SUAT-lhy/MEISHA-V100-A-Silicon-Proven-Quad-Core-RISC-V-SoC/trunk/hw/ip/sdspi/doc/sdio.pdf

# Gisselquist Technology, LLC

# SDIO/EMMC CONTROLLER SPECIFICATION

Dan Gisselquist, Ph.D.

## dgisselq (at) ieee.org

## August 19, 2023

Gisselquist Technology, LLC | Specification | 2023/08/19

Copyright (C) 2023, Gisselquist Technology, LLC
This project is free software (firmware): you can redistribute it and/or modify it under the terms of the GNU General Public License as published by the Free Software Foundation, either version 3 of the License, or (at your option) any later version.
This program is distributed in the hope that it will be useful, but WITHOUT ANY WAR-RANTY; without even the implied warranty of MERCHANTIBILITY or FITNESS FOR A PAR-TICULAR PURPOSE. See the GNU General Public License for more details.
You should have received a copy of the GNU General Public License along with this program. If not, see http://www.gnu.org/licenses/ for a copy.
www.opencores.com | Rev. 1.0 | ii

# Revision History

Rev. | Date | Author | Description
1.0 | 8/15/2023 | Gisselquist | First release
www.opencores.com | Rev. 1.0 | iii

# Contents

Page

www.opencores.com | Rev. 1.0 | iv

# Figures

Figure | | Page
3.1. | SDIO/eMMC Controller RTL Architecture | | 6
3.2. | SDIO/eMMC CMD pin data flow | | 6
3.3. | SDIO/eMMC transmit data flow, to the device | | 7
3.4. | SDIO Verification IP | | 8
3.5. | All Verilog top-level model | | 9
3.6. | All Verilog top-level model | | 10
3.7. | Software Stack | | 10
5.1. | CMD Register fields | | 19
5.2. | PHY Front end configuration register | | 23
www.opencores.com | Rev. 1.0 | v

# Tables

Table | | Page
5.1. | I/O Peripheral Registers | | 19
5.2. | CMD Register field descriptions | | 20
5.3. | CMD response types | | 21
5.4. | CMD response types | | 21
5.5. | Potential receive error codes | | 22
5.6. | PHY Front end configuration register fields | | 24
5.7. | Clock division settings | | 25
7.1. | Wishbone Slave Datasheet | | 27
9.1. | List of IO ports | | 29
www.opencores.com | Rev. 1.0 | vi

# Preface

After using the SDSPI companion controller for many years, I came across the need for an eMMC controller. Specifically, I needed a controller that could verify that two hardware interfaces were working. The first was a full SDIO interface, the second an eMMC interface,
Since the companion SDSPI IP already existed and was sufficiently low logic, this IP took on a different set of goals. First and foremost, it was to support the full SDIO interface–all of it. Every timing mode was to be supported, as were all commands. This includes the multiple block read and write commands, not supported by the SDSPI driver. This was also built to support eMMC devices– to include both the data strobe and the eMMC device interrupt. Unlike the SDSPI controller, low logic was no longer one of my goals.

Dan Gisselquist, Ph.D.

www.opencores.com | Rev. 1.0 | vii

1.

# Introduction

This SDIO/eMMC IP core is a redesign of the SDSPI IP, specifically focusing on full feature support. Low-logic, a key goal of the SDSPI companion IP, is no longer a goal. Key measures instead include full feature support and high device throughput. A full list of the features of this IP may be found in Chapt. 2.
For those interested in the basic architecture of how this controller is put together, Chapt. 3 describes its basic components and provides illustrations of how those components work together to accomplish the various actions required of the IP. Chapt. 3 will also discuss the components of the verification architecture.
I am aware that there is an official SDIO controller register set standard. This IP does not support it, but rather uses its own register set configuration. One reason for this is simplicity. The official register set standard appeared, upon inspection, more complicated than necessary. Second, since the SDSPI register set worked so well, there didn’t seem to be a need to generate something new.
As a result, most of the registers from the SDSPI controller have been replicated here. Like the SDSPI controller, this IP has CMD, DATA/ARG, and two FIFO registers. Unlike the SDSPI controller, a fifth register has been added for PHY configuration. This directly exposes what once was the internal configuration register of the SDSPI controller. Finally, even though this IP doesn’t yet support an internal DMA, three additional registers have been reserved for a DMA address and length for later DMA integration. Chapt 4 discusses how these registers can be used to accomplish the basic operations of the card, while Chapt. 5 goes through the definition of each register in detail. Finally, this is an Open Source project. The project is was initially developed using a combination of external funding and internal research and development dollars. My intention is twofold. First, I intend to use this project to both teach others, as well as for blogging material. From this standpoint, the project exists as part of a portfolio of projects available for others to examine and judge my skills and abilities by. My second goal is to use this as a background when providing services to my customers. My typical contract is for an hourly rate only, and comes with full access to any IP I have developed. As such, additional work on this IP may be done on a pay-per hour basis. Where this project supports another project of mine, I will bill that project for any required maintenance. Likewise, if you find this IP almost meets your needs, then feel free to contract with me for any maintenance adjustments or upgrades you might need.
www.opencores.com | Rev. 1.0 | 1

2.

# Features

This IP has been designed from the ground up for full SDIO/eMMC feature support. This means that support has been built in for the following specific requirements:

- Full IO support
– | Support for both open-drain and push-pull IOs are available.
– | Both SDR and DDR modes are supported, for clocks up to 2x the system clock.
– | IP supports either 1, 4, or 8 bit bus widths
– | The eMMC data strobe is supported
- Supports both multiblock read and multiblock write commands.
These are commands that were not supported by the SDSPI IP. They are supported here, at the cost of additional logic, since the goals of this project include both full feature support and high device throughput. Therefore, these features are supported at the cost of more logic.
- Ping-pong FIFO support, so one FIFO may be active on the bus while the other is active in a transaction.
- Internal CRC generation and checking, for both command and data interfaces
- Both RX and Command timeout support. Timeouts may be adjusted at build time.
- Card detection support
- Integer clock division support starts at 2x the system clock rate, and can divide the clock all the way down to 1/1,000th of the system clock rate. Thus, for a 100 MHz system clock, clock frequencies supported include 200 MHz, 100 MHz, 50 MHz, 25 MHz, 12.5 MHz, 10 MHz, 8.3 MHz, etc., all the way down to 100 kHz.
- The SDIO clock may be stopped upon request, once all operations have come to a stop.
- Special support for eMMC’s GO IRQ STATE command. Receive timeout detection is suspended for this command. Further, it is possible to self-send a reply to this command to exit interrupt mode if the device doesn’t generate an interrupt fast enough.
- Includes software driver support for use with FATFS
- Both Verilator C++ and all Verilog device verification models are provided
www.opencores.com | Rev. 1.0 | 2

- While the IP is built for big-endian buses, optional little endian support exists
- All of the various IP modules, save for the front end itself, can be formally verified.
- 32-bit Wishbone interface.

An AXI–Lite interface may be purchased upon request. If you have no interest in purchasing such support, feel free to use the AXI to Wishbone bus bridge (https://github.com/ZipCPU/wb2axip/blob/master/rtl/axim2wbsp.v) found in my wb2axip repository. (https://github.com/ZipCPU/wb2axip)

Many, although not all, of these features have been tested as part of the 10Gb Ethernet switch KlusterLab project. It is in this project that the software has been tested and proven, and where its utility has been demonstrated.

## 2.1 Limitations

As of this current release, the IP is not as fully featured as I might like. Several details and features are missing and may (or may not) be developed in the near future as time, funding, and necessity require. The following list, therefore, outlines some of the key limitations of the controller as it exists today. It also provides a roadmap for future development.

- IO features not yet tested in hardware include: OSERDES support, DDR support, and data strobe support. To date, these features have only been tested either formally or in simulation or both.
This is due to both the voltage requirements of these extra features, as well as current circuit board design I am testing against. High speed support requires 1.8V not 3.3V, and (worse) requires a voltage switch from 3.3V to 1.8V. Second, the voltage translator we are using limits speeds to 60MHz in order to maintain the ability to support open–drain IO. Similarly, wiring the clock pin to Xilinx’s CCLK pin has limited the clock in the devices under test to a maximum of 50 MHz. Finally, success with the data strobe pin really requires that the data strobe be wired to a clock capable pin. I expect these hardware testing limitations will be addressed in the future with a better PCB design, but for the time being this statement outlines hardware testing success to date.
Please check the hwteststat.png file in the doc/ directory for the current status, and any updates on this issue.
- The verification model only supports SDIO devices at present. No model yet exists for eMMC devices.
Most of the smarts in the verification IP exists in the model’s FSM, whereas the challenging components of the interface are encapsulated in supporting modules. As a result, fixing the FSM should be a fairly easy task.
Given that the two interfaces are so similar, this hasn’t (yet) been a drawback.
- The verification model depends upon an internal memory buffer which can become quite large. Further, it doesn’t integrate nicely with the FatFS system.
Plans exist to replace the memory buffer in the SDIO VIP with a file backing. This should make it possible to model full sized SD cards.
www.opencores.com | Rev. 1.0 | 3

- The included verification test suite doesn’t (yet) support testing the software driver.
A plan exists for integrating the ZipCPU into the verification environment for the purpose of verifying the software driver in simulation.
- DMA support (currently) requires an external DMA, and transfers are limited to 32-bits per clock.
Initial plans are in place for integrated DMA support. Such an integrated controller would use the full bus width for all transfers. Unfortunately, I have no requirement for such support at this time.
- There’s no eMMC boot support at present.
This also means there’s no support for either CRC acknowledgement or negative acknowledgement tokens.
Boot support may be added in the future. As with the DMA feature, I have no requirement for this capability at present.
- The model doesn’t (yet) support all SDIO commands.
As additional commands are required, they will be added. At present, however, the model is sufficient to verify IP startup and data transfer.
- Although the design has been tested and proven in hardware, not all of those hardware tests can currently be repeated in the included verification infrastructure.
www.opencores.com | Rev. 1.0 | 4

3.

# Architecture

Three basic architectures are discussed in this chapter. The first is the hardware architecture. This will outline the various hardware components composing the design, and discuss their purpoes. The second is the verification architecture, used to test and verify the various components of the design. Finally, this chapter will conclude with a quick review of the software driver architecture that allows a single FATFS library to be able to interact with all three of the design components here: SDSPI, SDIO, and eMMC.

## 3.1 Controller Architecture

The basic SDIO/eMMC RTL architecture is shown in Fig. 3.1. The design is broken up into two parts at the top level: a hardware independent, all digital logic component whose top level is sdio.v, and a hardware dependent front end component whose top level is found in sdfrontend.v.
The core controller, found in sdio.v, itself is composed of five separate components. The first, sdwb.v, is the controller. This component is a wishbone slave. All user interaction goes through this controller. Requests for transfers are made here. Data to be transferred is stored here in one of two FIFOs for transmission to the front end. Data to be received is stored here after reception, to be read out as it becomes available to the CPU.
The controller maintains a register for configuring the front end. This register also controls the clock generator, sdckgen.v. This clock generator is responsible for generating the clock used throughout the system. That clock is an 8-bit vector, allowing it to specify zero, one, or up to two clock periods, each either aligned with or 90 degrees offset from the data, per 8-bits. This clock may also be divided to slower speeds as requested by the user. Finally, a user setting allows the clock to turn off when it isn’t being used, to save on interface power. (Note that this only turns off the IO clock, not any of the system clocks used throughout the design to clock the logic within the design.) Commands issued to the controller will be forwarded to the sdcmd.v module. This module is responsible for all interactions taking place over the CMD wire. The module can generate 48-bit commands, beginning with a start bit and ending with a CRC and a stop bit. It can then recognize either 48-bit or 136-bit command responses. Responses are checked against both the CRC and frame errors. If the device fails to return a response within a given timeout window, the response may also timeout with an error, after which the command controller will no longer expect any response until the next command is sent.
Fig. 3.2 shows both the basic command flow, and the two possible response flows. For commands, a data register within sdwb.v is first set, then the command is issued. The sdcmd.v module organizes both into a 48-bit word to be transmitted. The sdcmd.v module then looks for one of two responses,
www.opencores.com | Rev. 1.0 | 5

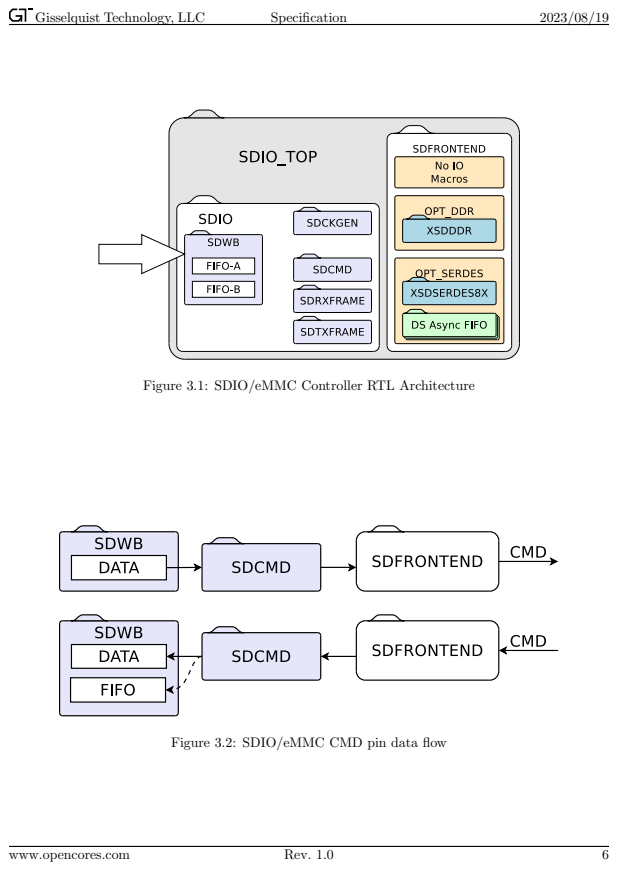
[picture p28: page 13]
www.opencores.com; Rev. 1.0

Figure 3.1: SDIO/eMMC Controller RTL Architecture

Figure 3.2: SDIO/eMMC CMD pin data flow

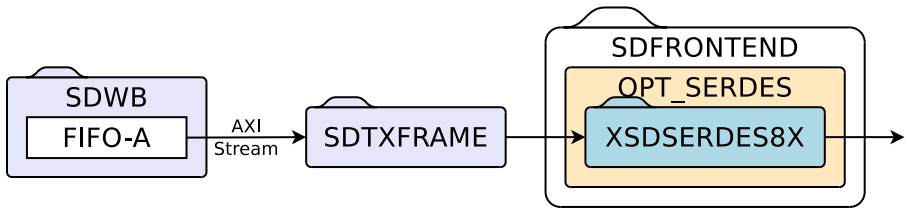
[picture p29: figure]

Figure 3.3: SDIO/eMMC transmit data flow, to the device

either a 48–bit response which would place the 32-bit argument back in a data register, or a 136–bit response which would be placed into one of the two FIFOs in sdwb.v.
One type of controller command is a memory command. These commands send a 48-bit command to the device, followed by sending data to or receiving data from the device.
The sdrxframe.v component is activated when data is expected from the device on the data wires. It’s purpose is to collect the data returned from the front end controller, and reform that data into commands to write to one of the FIFOs in sdwb.v. If a full frame, as defined by the controller, is not received prior to a timeout, or if a CRC error is detected within that frame, the receive component will report an error and give up in order to wait for its next command. Similarly, the sdtxframe.v command is activated when data is to be sent over the data wires to the device. In this case, data flows from one of the FIFOs in sdwb.v to sdtxframe.v, get formatted for the front end to output, a start bit, CRC, and stop bit are added, and all get sent to the front end. This basic flow is shown in Fig. 3.3.
Let’s now turn our attention to the device dependent front end.
The front end was initially defined for full IO support, all the way up to HS400 and the eMMC data strobe. Driven from a 100 MHz clock, this means that this front end was designed to support up to two device clocks per 100 MHz system clock, and to have data sent on each edge of these clocks. This forces a requirement of 4-data bits output per 100 MHz system clock cyle. The clock, however, also needs to be (potentially) offset by 90 degrees from that data. As a result, all I/O using this particular front end capability, called the OPT SERDES capability in Fig. 3.1, takes place using Xilinx’s 8:1 OSERDES elements. Incoming bits are either sent to an asynchronous FIFO, to support the eMMC data strobe, or they are sampled via 1:8 ISERDES elements. In the case of the ISERDES inputs, sample timing is controlled via both the output clock rate, as well as a user controlled digital delay, allowing sample alignment with clock precision of one eighth of a system clock. Hence, even without the full speed HS200 support, this subsample re-alignment may still be quite valuable when supporting higher speeds. All Xilinx specific SERDES interactions are captured in an xsdserdes8x.v module.
Logic resources throughout the design may be reduced, however, by switching to a simpler front end architecture. Two other architectures are available: the OPT DDR architecture and a plain architecture that doesn’t use any IO macros–save for the IOBUF macro used for controlling any tristate capabilities.
The OPT DDR architecture is roughly the same as the OPT SERDES architecture, save the DDR IO elements are used to generate both clock and data instead of the SERDES elements. This should make it possible to drive the IO pins at the full clock speed using SDR, or at half the clock speed using
www.opencores.com | Rev. 1.0 | 7

Figure 3.4: SDIO Verification IP

DDR. In this case, all Xilinx specific IDDR and ODDR interactions are captured in an xsdddr.v module.
The no macro architecture was built in order to support an architecture where the SD CK pin was routed through the Xilinx CCK pin, and hence through an STARTUPE2 primitive. In this case, no IO macros are available for controlling the clock, and all IOs are controlled directly from logic. The fastest clock this architecture can generate is half the system clock rate.
These constitute the basic components of the controller, both hardware independent and hardware dependent.

## 3.2 Verification Architecture

The verification architecutre is built around a model of the downstream device. One such model is shown in Fig. 3.4. This Verification IP contains full featured submodules for handling the command wire, receiving data, and transmitting data. These three submodules are designed to correspond to their host controller counterparts. Further, these three submodules have been built to be independent of whether the controller is modeling an SDIO or an eMMC interface.
The smarts of this Verfication IP (VIP) are found in the finite state machine (FSM) at the top level of mdl sdio.v. This machine respnds to commands, and generates responses to them. A data transfer buffer exists for sending or receiving data across the interface. A second memory within the VIP, shown as MEM in Fig. 3.4, captures the persistent memory found in the SDIO or eMMC device. The entire Verilog test bench infrastructure is diagrammed in Fig. 3.5. In this setup, a test script drives a Wishbone Bus Functional Model (BFM). The BFM then drives the controller to interact with the VIP model. What tests get accomplished at this point is dependent upon the test script. A test library is available, for the purpose of defining common constants and supporting common test script tasks.
www.opencores.com | Rev. 1.0 | 8

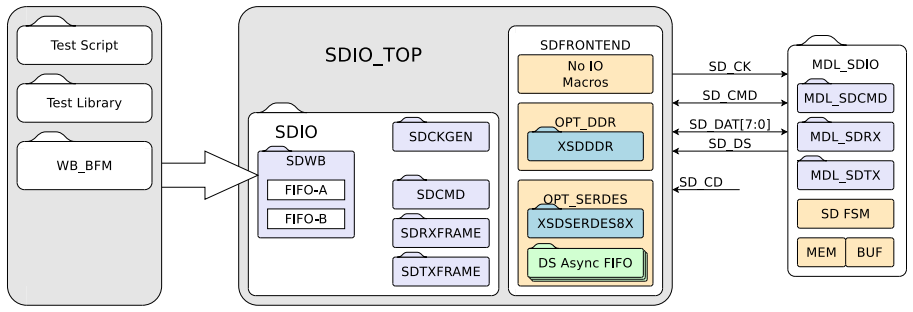
[picture p30: figure]

Figure 3.5: All Verilog top-level model

A second test bench infrastructure, shown in Fig. 3.6, is also planned. This infrastructure contains a soft–core ZipCPU, serial console, and memory. In this test architecture, the test script exists as a software program supported by both the FATFS library and the software driver. The purpoes of this second infrastructure is to specifically test and verify the software driver in its native (software) form, compiled for and then running on a soft–core CPU. In this case, that softcore CPU will be the ZipCPU.

## 3.3 Software Driver Architecture

At present, there exist three software drivers and one glue layer for each. The three drivers are found in the sw/ directory. These drivers are:

- sdspidrv.c: A software driver for the SPI version of this controller. The SPI version of this controller is described in the SDSPI user guide.
- sdiodrv.c: A software driver for the SDIO controller, described in this user guide. This controller is designed to interact with an SD Card.
- emmcdrv.c: A software driver for the eMMC controller. This is designed to interact with the same SDIO/eMMC controller discussed in this user guide. However, the SDIO and eMMC protocols require different commands to interact with their respective devices. As a result, the eMMC software driver differs significantly from the SDIO software driver.
- diskiodrvr.h provides a common definition of a device “driver”, which can be used across all of the device drivers listed above.
More on this in a moment.
- diskio.c is a shared/common dispatch glue layer. Commands from the FATFS subsystem naturally land here, where they are then dispatched to the appropriate controller.

Put together, this IO subsystem has the various layers shown in Fig. 3.7. User software interacts with the FATFS layer. FATFS then interacts with the device dispatch layer. The device dispatch layer then instantiates and interacts with one (or more) of the device drivers beneath it.

www.opencores.com | Rev. 1.0 | 9

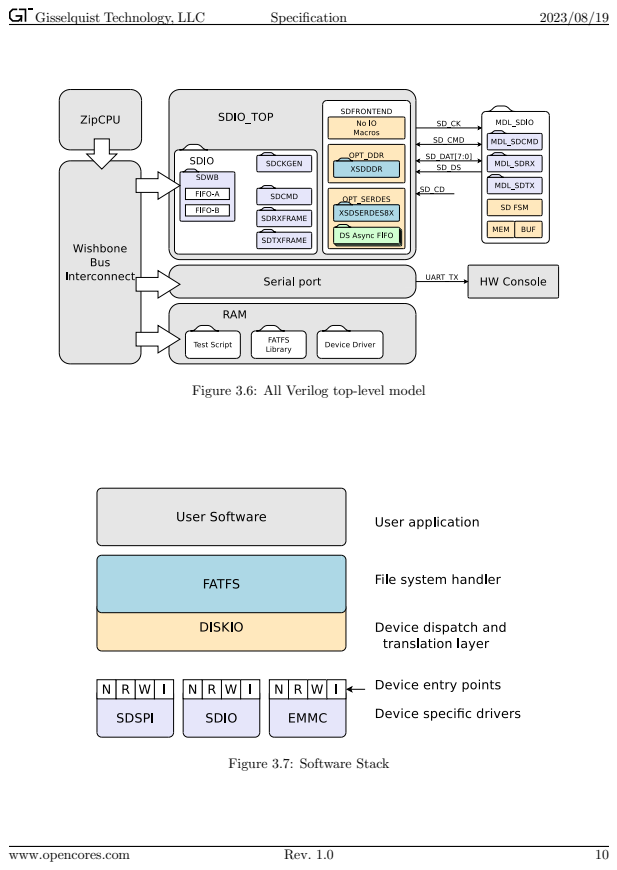
[picture p31: page 17]
www.opencores.com; Rev. 1.0

Figure 3.6: All Verilog top-level model

Figure 3.7: Software Stack

Each device driver has four entry points–“methods” in Object Oriented terminology. The first method is used to initialize the driver and set up its data structures. After that, there are methods for reading and writing. Finally, there’s an IOCTL method which can be used for other tasks such as querying the size of the device or the size of a data block.

www.opencores.com | Rev. 1.0 | 11

4.

# Operation

At its most basic level, interacting with the controller simply involves configuring the PHY, setting the data you wish to send, and then sending a command to the controller. This needs to take place, however, in many different contexts. Some commands don’t expect responses, whereas others return 48 or even 136–bits. Some commands include data transmission, whereas others do not. This section therefore walks through several examples of commands, illustrating the range of commands and responses that can be issued using this controller.

## 4.1 Initial PHY setup

The first step to any operation is to make sure that the PHY register is appropriately set up for the clock speed desired, the transfer rate desired, and whether or not the design will be using open– drain or push–pull IOs. Any changes made to this register will be applied immediately, save for any changes to the clock rate. Clock rate changes will take place starting at the top of the next clock cycle. Hence, once a clock rate change has been made, it makes sense to wait until the current clock matches the requested clock rate.
The following, for example, will set up a 100 kHz clock rate using open–drain IOs and 512 byte sector sizes. This is appropriate for beginning communication with the device.
const | SDIOCK 100KHZ = 0x000000fc ,
SPEEDSLOW | = SDIOCK 100KHZ,
SPEED 512B | = 0x09000000;
sd io - >sd phy = SPEEDSLOW | SECTOR 512B;
while(SPEEDSLOW != ( sd io - >sd phy & 0 x0 f f )) ;

## 4.2 GO IDLE: Commands that don’t get responses

Sending a command to the device is as easy as setting the commands 32’bit data, and then writing the appropriate command to the command register. All command writes set bits [7:6] to 2’b01. Noncommand writes will set these bits to something different. At the same time you write a command to the controller, you’ll also want to tell the controller what type of response to expect–whether to expect no response at all, an 48-bit (R1) response, or a 136-bit (R2) response.
When issuing a command, you also want to be aware of the error bit. If the error bit gets set, no commands will be accepted until the error bit is cleared. Hence, you’ll want to clear the error
www.opencores.com | Rev. 1.0 | 12

bit at the beginning of any command sequence, and check it when you are done to see where any error took place.
Finally, in the case of the first command used when interacting with a device, you’ll want to clear the controller’s card-removed bit. You can then check this bit later, at your convenience, to know if the card has ever been removed and (if so) if you need to start your initialization sequence again from the SEND GO IDLE command.
Put together, this would look like:
const | SDIOREMOVED = 0x00040000,
SDIO ERR | = 0x00008000,
SDIO RNONE | = 0x00000000,
SDIO CMD | = 0x00000040;

sd io - >sd data = 0;
sd io - >sd cmd = SDIOREMOVED | SDIO CMD | SDIO RNONE | SDIO ERR;

The next step is to wait for the command to complete. This can be done either by polling the controller,

const | SDIOREMOVED = 0x00104800;
unsigned | st ;
st = | sd io - >sd cmd;
while( st & SDIO BUSY)
st = sd io - >sd cmd;

or by waiting for a controller interrupt.

// SDIO_INT is the interrupt number assigned to the
// design . | It ’s set external to the controller .
unsigned | st ;
st = | sd io - >sd cmd;
while( st & SDIO BUSY) {
| CLEAR INT(SDIO INT);
WAIT INT(SDIO INT);
}

## 4.3 SEND IF COND: R1 commands

The next type of command the controller understands are what are called R1 commands. These are commands that expect a 48-bit response–whether or not that response truly contains an R1 register or any other register.
The first R1 command in the startup script is the SEND IF COND command, also known as CMD8. This command requires a special argument. We’ll allow that argument to arrive via the variable ifcond. This variable is first placed in the sd data register, and then the command is issued.
www.opencores.com | Rev. 1.0 | 13

const | SDIO R1 | = 0x00000100,
SDIOREADREG = SDIO R1 | SDIO CMD;

sd io - >sd data = i fcond;
sd io - >sd cmd = SDIOREADREG+8;

wait while busy();

Once the command returns, the first 8-bits of the 48-bit return may be read from the sd cmd register. If the protocol has been followed and the device has returned a value, then bits [7:6] of this register will now be zero. The next 32-bits may be read from the sd data register, to know how the device has responded. The last 8-bits, both CRC and stop bit, are not returned. Instead, the error bit and error code may be checked to know if the CRC is correct and the stop bit valid.

## 4.4 ALL SEND CID: R2 commands

The last type of command is the R2 command. These commands read 136-bits from the device. The first 8-bits of these are read into the command register, as with the R1 commands. However, the next 128-bits will not fit into the data register. Instead, they are returned into one of the two FIFOs.
Sending such a command follows the same script as before. The difference is that we could now specify, in our command, which FIFO to write the results into. We’ll use FIFO A, the first FIFO, which is the default for this example.
const | SDIO R2 | = 0x00000200,
SDIOREADREG = SDIO R2 | SDIO CMD;

sd io - >sd data = 0;
sd io - >sd cmd = (SDIO ERR|SDIO READR2) + 2;

wait while busy();

If this particular command works, it is likely to set the CRC error bit. This is normal for a CMD2, although not so normal for other commands.
Once the command completes, the CID register can be read from the FIFO 32-bits at a time.
unsigned | | d CID[4];
d CID[0] = | sd io - > s d f i f a ;
d CID[1] = | sd io - > s d f i f a ;
d CID[2] = | sd io - > s d f i f a ;
d CID[3] = | sd io - > s d f i f a ;

If the controller has been configured for big–endian operation, then the MSB byte of each FIFO result will be the first byte read from the device.
The d CID values may then be decoded and processed by the software driver.
www.opencores.com | Rev. 1.0 | 14

## 4.5 Adjusting the PHY

Once any cards have been properly enumerated, the PHY may be adjusted for higher speed. The first speed change below simply changes the clock speed to 25MHz, and the IOs from open–drain to push–pull.

const | SDIOCK 25MHZ = 0x00000003,
SPEED 512B | = 0x09000000;
sd io - >sd phy = SECTOR 512B | SDIOCK 25MHZ | SDIO PUSHPULL;
while(SDIOCK 25MHz != ( sd io - >sd phy & 0 x0 f f ))
; // Wait for the clock change

A later PHY adjustment might even include switching to 4–bit data mode.

const SDIO W4 = 0x00000400;

sd io - >sd phy = SECTOR 512B | SDIOCK 25MHZ | SDIO PUSHPULL
| SDIO W4;

In this final example, we don’t need to wait for the change to take place. The interface was already idle, so it took place immediately.

## 4.6 Reading a sector

Once the SD card has been set up, the next step may be to read a sector of data. In general, this is as simple as enabling the FIFO when issuing the command, and then reading the data from it once the command has been complete.
The SDIO driver first, however, checks whether or not the card has been removed. This is appropriate, lest the card has been swapped unbeknownst to the controller.

i f sd io - >sd cmd & SDIOREMOVED)
return CARDREMOVEDERR;

If the card has not been removed, then we can issue a command to read a block. This involves setting the SDIO MEM bit and (potentially) the FIFO bit to select which FIFO we are interested in.

const | SDIOMEM | = 0x00000800,
SDIO READBLK = (SDIO CMD|SDIO R1|SDIOMEM)+17;

sd io - >sd data = sector ;
sd io - >sd cmd = SDIO READBLK;

wait while busy();

Once the read completes, we can check for any errors.
Assuming the read completed without error, we can then read the data back out of the controller.

for ( int k=0; k<512/ s i z e o f (u int32 t ); k++)
buf[k] = | sd io - > s d f i f a ;
www.opencores.com | Rev. 1.0 | 15

Note that the FIFO’s are always 32-bit aligned. Whether or not the buffer is aligned, or whether or not the CPU supports unaigned accesses in the case where it isn’t, aren’t controller issues.
The ZipCPU’s DMA may also be used to read from this controller if desired for higher speed.

## 4.7 Writing a sector

Writing a sector to the device is very similar to reading, however, there are a few minor key differences. The first key difference is that the memory needs to be loaded into the FIFO first, before it can be sent to the device.

for ( int k=0; k<512/ s i z e o f (u int32 t ); k++)
sd io - > s d f i f a = buf[k];

The second key difference is that the controller doesn’t know when to write to the device or when to read from it. In general, the controller doesn’t know the meanings of any of the commands. Therefore, if a command needs to use the FIFOs, the controller needs to be told. Likewise, if the data is suppoesd to flow from the FIFO to the device instead of from the device to the FIFO, the controller also needs to be told. For this reason, a separate bit needs to be set in addition to the previous ones–one to indicate that this is a write and not a read.

const | SDIO WRITE | = 0x00000400,
SDIOWRITEBLK = (SDIO CMD | SDIO R1 | SDIO ERR
| | | SDIO WRITE | SDIOMEM) + 24;

sd io - >sd data = sector ;
sd io - >sd cmd = SDIOWRITEBLK;

wait while busy();

## 4.8 Writing multiple sectors

Writing multiple sectors to the device is very similar to writing a single sector. Indeed, the instructions for writing the first sector are identical, save that the command is now a CMD25 instead of a CMD24. Things become different when it comes to writing subsequent sectors, and then when it comes to ending transmission.
Let’s walk through these changes one by one.
The first change is that we don’t initially wait for the write to complete.
const | SDIO FIFO | = 0x00001000;

sd io - >sd data = sector ;
sd io - >sd cmd | = (SDIO CMD | SDIO R1 | SDIO ERR
| | | SDIO WRITE | SDIOMEM) + 25;

Instead, we load a second sector into the FIFO. In general, we’ll alternate which FIFO we use.

www.opencores.com | Rev. 1.0 | 16

unsigned * src = &buf[ s *512];

i f ( s &1) {
for ( int w=0; w<512/ s i z e o f (u int32 t ); w++) sd io - > s d f i f b = src [w]; } e l s e {
for ( int w=0; w<512/ s i z e o f (u int32 t ); w++) sd io - > s d f i f a = src [w]; }

Once the second sector has been transferred to FIFO memory, we can then wait for the current write transaction to complete and issue a new write request for the next sector.

while( sd io - >sd cmd & SDIO BUSY)
;
sd io - >sd cmd = (SDIO WRITE | SDIOMEM)
+ (( s & 1) ? SDIO FIFO : 0)

At this point, we repeat until we’ve written all of the sectors we wish to write to. Once we are done, we can send an R1 command to STOP TRANSMISSION.

## 4.9 Reading multiple sectors

Reading multiple sectors is almost identical to writing multiple sectors, save that the operation proceeds in reverse.
First, the command is issued to read multiple sectors. We then wait for that command to complete. Once complete, we immediately switch FIFOs and issue a command to store the read data into the next sector. This is also a good time to check for any read errors that may have taken place while reading the last sector.

while( sd io - >sd cmd & SDIO BUSY)
;

i f (0 != sd io - >sd cmd & SDIO ERR) err = 1; // No more commands to issue on error

i f ( s + 1 < count && ! err ) {
| // Immediately start the next request sd io - >sd cmd = SDIOMEM + (( s &1) ? 0:SDIO FIFO) + 18;

} e l s e {
| // Send a STOP_TRANSMISSION request
sd io - >sd data = 0;
| sd io - >sd cmd = (SDIO CMD | SDIO R1 | SDIO ERR) + 12;
}

This second command must be issued before the device starts sending the second sector of data. Once the second read request is away, we have until it finishes to copy the data out of the first FIFO.

www.opencores.com | Rev. 1.0 | 17

unsigned *dst = &buf[ s *512];

i f ( s &1) {
for ( int w=0; w<512/ s i z e o f (u int32 t ); w++) dst[w] = sd io - > s d f i f b ; } e l s e {
for ( int w=0; w<512/ s i z e o f (u int32 t ); w++) dst[w] = sd io - > s d f i f a ; }

Again, these operations are time sensitive: the must be done before the SD card sends the next sector. There’s no handshaking method to slow the SD card down.¹

## 4.10 GO IRQ STATE

The one command that the IP knows by number is the GO IRQ State command, CMD40. This command needs to be treated special, because it has no timeout. It also needs to be treated special, so that the controller can end the command.
The first step in the GO IRQ STATE command is to switch to an open–drain IO mode. This will likely also mean that we need to switch clock speeds as well.
sd io - >sd phy = ( sd io - >sd phy & ~(SDIO PUSHPULL | 0 x0 f f ))
| SDIOCK 25MHZ;

We can now issue the GO IRQ STATE command.

sd io - >sd data = 0;
sd io - >sd cmd = SDIOREADREG + 40;

At this point, we need to wait for either an SDIO controller interrupt, indicating that the SDIO command has completed and an R1 response has been read, or a timeout indicating something has gone wrong and we don’t wish to wait any longer.
If the response has been read, then the command is complete and we are done. We can clean up by restoring the PHY to its original mode.
If no response has been read and the command has timed out, then we need to create a self–reply to this command.

sd io - >sd data = 0;
sd io - >sd cmd = 40;

Once this command completes, we are done and can return the PHY to its original mode. No valid data will be returned from this command.
There exists the possibility that this command will step ontop of an actual return from the eMMC card. Electrically, this should be okay since we’ve returned to open drain mode.

1One goal of the (to be written) DMA is to solve this race condition. Until then, the CRC may be checked to know if a sector was received in error or not.

www.opencores.com | Rev. 1.0 | 18

5.

# Registers

As mentioned in the last two chapters, the SDSPI core has five registers. These are shown in Tbl. 5.1. An additional three registers, shown at the end of this list, have been reserved for a future DMA

Name | Address | Width | Access | Description
CMD | 0x00 | 32 | R/W | SDSPI Command and status register
ARG | 0x01 | 32 | R/W | SDSPI return data/argument register
FIFO[0] | 0x02 | 32 | R/W | FIFO[0] data
FIFO[1] | 0x03 | 32 | R/W | FIFO[1] data
PHY | 0x04 | 32 | R/W | Front end configuration register
DMA Addr | 0x05 | 32 | R/W | Reserved for DMA address bits[31:0]
DMA Addr | 0x06 | 32 | R/W | Reserved for DMA address bits[63:32]
DMA LEN | 0x07 | 32 | R/W | Reserved for DMA transfer length

Table 5.1: I/O Peripheral Registers

capability. Of these registers, the most powerful is the command register, CMD, so we’ll spend most of our time discussing that one.

## 5.1 CMD Register

Only writes to the CMD register will cause the device to act. The CMD register itself is composed of several packed bit fields, as shown in Fig. 5.1. The various fields of this register are explained in Tbl. 5.2.
In general, a command will be issued any time bits [7:6] of the command register are 2’b01. There are some exceptions to this rule:
- If the error bit is set, then any command without bit 15 (clear error) set will be ignored.
- If the device is already busy with another command, then any new command will be ignored.
31 | 30 | 29 | 28 | 27 | 26 | 25 | 24 | 23 | 22 | 21 | 20 | 19 | 18 | 17 | 16 | 15 | 14 | 13 | 12 | 11 | 10 | 9 | 8 | 7 | 6 | 5 | 4 | 3 | 2 | 1 | 0
(Reserved) | Cr | Er | Ec | CB | P | R | CC | E | B | D | I | M | W | T | CMD

Figure 5.1: CMD Register fields

www.opencores.com | Rev. 1.0 | 19

Name | Width | Description
Cr | 1 | Receive error code. On any receive error, indicates the cause of the
| | error.
Er | 1 | Receive error. Set if the E bit is set due to a data reception error.
Ec | 1 | Command error. Set if the E bit is set due to a command error.
CB | 1 | Card is busy. Following a command that expects an R1b response,
| | the card may assert a busy signal by lowering DAT[0]. If it does,
| | this bit will be set until the card releases DAT[0].
P | 1 | No card present. Set if the card detect bit indicates no card is
| | currently present. This bit will automatically clear when a card is
| | inserted. Only active if the OPT CARD DETECT parameter is also set.
R | 1 | Removed. The card detected bit has dropped since a card was last
| | acknowledged. Write a one to this bit to clear it. Only active if
| | the OPT CARD DETECT parameter is also set.
CC | 2 | Command error code. Indicates the type of error, if any, received
| | from the last command.
E | 1 | Error. The last command or data receipt completed with error.
| | Once set, further commands will be ignored. Write a one to this bit
| | to clear it. Errors may be cleared concurrent with new transactions
| | requests.
B | 1 | Busy. Either a command or data transfer is currently in progress.
D | 1 | (Reserved for DMA control)
I | 1 | FIFO selection. Keep clear to use FIFO A. Set to use FIFO B.
M | 1 | Memory operation. Once the command is complete, a memory
| | read or write will take place. If this bit is set and bit[6] is clear,
| | then a memory operation will take place without an associated
| | prior command and response.
W | 1 | Write operation. If this bit is set for a memory operation, then
| | data will be transferred from a FIFO to the device. Otherwise,
| | and memory operation is a read operation, which will transfer data
| | from the device to the FIFO.
T | 1 | Response type. Indicates whether a response is expected, and
| | whether or not that response will have 48’bits or 136’bits.
CMD | 8 | The command. Writes with bits [7] equal to 1’b0 will issue a co-
| | mand to the controller, although memory commands require bit
[6] be set as well. Upon command completion, these bits will be
| | replaced by the first 8–bits of the reply.

Table 5.2: CMD Register field descriptions

www.opencores.com | Rev. 1.0 | 20

Resp Type | Description
2’b00 2’b01 2’b10 2’b11 | No response expected R1 (48b) response expected R2 (136b) response expected. Returned data will be placed into the selected FIFO. R1b (48b+BUSY) response expected

Table 5.3: CMD response types

CMD Err Code | Description
2’b00 2’b01 2’b10 2’b11 | Timeout. The card has not responded. This will also be the return code for commands not requiring any response. Okay. No error was encounted, and the card returned a valid re-sponse. CRC Error. The response returned by the card did not have a valid CRC. Not all commands will have valid CRCs. Check the SDIO and eMMC specifications to know when to expect one. Frame error. Set if the CRC passes, but the stop bit of any com-mand reply is not also set.

Table 5.4: CMD response types

- If the FIFOs are busy with a previous command, then any new command that would use the FIFOs will also be ignored.
- If bits [7:6] are both zero, a new command will be issued if the device was configured with eMMC support (OPT EMMC=1), no FIFO activity is requested, and no response is expected. This is to support the ‘self-reply’ capability designed to force a slave to exit the IRQ state.

Commands may expect one of four types of responses, as shown in Tbl. 5.3.
If the memory bit is set, then the data FIFOs will be used in the operation. Which FIFO is used will be controlled by the FIFO ID bit. “Write” transactions, those that transfer data from the FIFO to the card, are identified by also setting the ‘W’ bit, otherwise all FIFO transactions will be read transactions by default.
The “D” bit is reserved for operations that would enable the (not yet written, not yet integrated) internal DMA.
As soon as a command has been requested, the busy bit will be set. It will remain set while the command is being sent. If the command expects a response, then it will remain set while the controller awaits the response. If the command also expects a data transfer, then the busy bit will remain set while the data transfer takes place. Once the entire operation, command, reply, and optional data transfer, has completed the busy bit will be lowered.
The controller will return one of four results for any reply request, as shown in Tbl. 5.4. In general, any non–zero response indicates that a start bit was received.
www.opencores.com | Rev. 1.0 | 21

Rx Err Code | Description
1’b0 1’b1 | Watchdog timeout. Set if no bits are received within the watchdog timeout period. This will get set both if no start bits are received, as well as if the clock (or data strobe) stops mid-reception. CRC error. Set if a sector is received with an invalid CRC. May also be an indication that the received sector had started to arrive before the command to receive that sector had been given.

Table 5.5: Potential receive error codes

If the OPT CARD DETECT parameter is set, then the controller will be responsive to a “card detect” bit. Whether or not a card is currently present can be determined by the “No card present” bit. If ever a card is removed from the system, this bit will be set. A second bit, the card removed bit, will also be set if no card is present. Once a card is inserted, the “No card present” bit will clear automatically leaving only the “Card removed” bit to be cleared manually. This helps to insure that software can always detect any time a card has been removed: the “Card removed” bit will be set until cleared.
If the OPT CARD DETECT parameter is clear, then the “No card present” bit as well as the “Card removed” bit will always read zero.
If, following any command, the card holds the DAT[0] line low, this will be reflected in the “Card busy” bit. Although there is a command type for expecting an “R1b” command, this command type is not (currently) connected to this register. Once the card raises DAT[0], the “Card busy” line will be cleared automatically and will not reassert until the next command completes at the earliest. If, following any command, the card holds the DAT[0] line low, this will be reflected in the “Card busy” bit.
The error bit may be set from either a command or a data receiver error. The Er and Ec bits exist so you can know which of the two (or both) produced the current error.
Receive error codes are listed in Tbl. 5.5.

## 5.2 Argument register

According to both SDIO and eMMC specifications, all commands sent to the device have a 48–bit format. The first 8-bits specify a start bit followed by the 7–bit command itself, where commands from the host begin with a 2’b01 (including the start bit). The next 32-bits constitute an argument to the command. This argument register controls these next 32-bits.
Writes to this register, prior to issuing a command, will set the argument for the next command. Following any 48–bit reply from the device, the 32–bit argument from that reply may be read from this register.

## 5.3 FIFO Registers

As with the SDSPI controller, the SDIO/eMMC controller maintains two 512 byte memory areas called FIFOs. Reads from the card will write data into one of the two FIFO’s, whereas writes to the

www.opencores.com | Rev. 1.0 | 22

31 | 30 | 29 | 28 | 27 | 26 | 25 | 24 | 23 | 22 | 21 | 20 | 19 | 18 | 17 | 16 | 15 | 14 | 13 | 12 | 11 | 10 | 9 | 8 | 7 | 6 | 5 | 4 | 3 | 2 | 1 | 0
Rsrvd | LgBlk | VOVR | S | Shift | nCC9PCPD | W | DSDD | CLKDIV

Figure 5.2: PHY Front end configuration register

card will read data out from one of the FIFO’s. Which FIFO the card uses is determined by the I bit in the CMD register (above).
Further, upon any write to the CMD register, the FIFO address will be set to point to the beginning of the FIFO.
The purpose of the FIFOs is to allow one to issue a command to read into one FIFO, then when that command is complete to read into a second FIFO. While the second command is ongoing, a CPU or DMA may read the data out of the first FIFO and place it wherever into memory. Then, when the second read is complete, a third read may be issued into the first buffer while the data is read out of the second and so forth.
This interleaving approach, sometimes called ping-pong buffering, can also be used for writing: A multi–sector write might start by first writing into one FIFO. The write command would then be issued, followed by writing into the second (now unused) FIFO. Once the first write completes, a second write command may be issued while the first FIFO is refilled for a third command and so forth.
One item to note before closing: there is only one internal address register when accessing the FIFO from the wishbone bus. Attempts to read from or write to either FIFO from the wishbone bus will increment this address register. Interleaved read, or write attempts, such as reading one item from FIFO[0] and writing another item to FIFO[1], will each increment the internal address pointer so that the result is likely to be undesirable. For this reason, it is recommended that only one FIFO be read from or written by the wishbone bus at a time.

## 5.4 PHY Register

The PHY register controls the SPI clock rate and the sector size. Specifically, with regards to the FIFO size, it controls how many bytes will be written into the FIFO (which is really of a fixed size) before the expecting a CRC, or equivalently how many bytes to read out of the FIFO before adding a CRC. The fields of this register are shown in Fig. 5.2. and explained in Tbl. 5.6.
The CKDIV field needs the most explanation. This field is used to control a digital clock divider. Particular high speed frequency do not go through the divider. All other frequencies may be expressed as divisions of 50 MHz, as shown in Tbl. 5.7. Attempts to use the high frequency values, but without high frequency support, will be quietly ignored. Indeed, this can be one way of telling whether or not controller support exists for either OPT SERDES or OPT DDR.
This controller supports both SDR and DDR IO modes. DDR IO, however, requires that the clock be offset from the data by 90 degrees rather than the nominal 180 degrees. While the OPT SERDES driver will support 90 degree clock and data offsets at all frequencies, the OPT DDR driver will only do so at 25 MHz and below. Any attempt to enable DDR mode will automatically place the clock in its 90 degree offset mode. Alternatively, the 90 degree offset mode may be enabled specifically.
www.opencores.com | Rev. 1.0 | 23

Name | Description
LgBlk | 4 | Log based two of the transfer block size. Set to 9 for 512 Byte
| | transfers, 4 for 16‘Byte transfers, etc.
VO | 1 | Read only value reflecting the parameter OPT 1PV. If set, indicates
| | that the controller is capable of changing voltages upon request.
VR | 1 | 1.8 Volt request. Set to transition to 1.8 Volts, or leave clear to
| | operate at 3.3 Volts. Only relevant if OPT 1PV is set, and hardware
| | is present to allow voltage changes.
S | 1 | Read only value, indicating whether or not the OPT SERDES IOs are
| | in use. (May be removed in the future.)
Shift | 5 | Sample shift. This is used to determine IO sampling. The digtal
| | clock output signal will be delayed by one clock plus this many
| | eighth clock units to determine the receive sample point when not
| | using the data strobe. This is nominally set to zero during simula-
| | tion testing, but many need to be adjusted due to IO delays from
| | the external device.
nC | 1 | Clock shutdown. Set in order to deactivate the clock between com-
| | mands, or leave clear for a continuously operating clock.
C9 | 1 | Clock–90. Set in order to offset the clock from the data by ninety
| | degrees, or leave clear for the two to be offset by 180 degrees. Any
| | attempt to use DDR data transfer will automatically set this bit.
PC | 1 | Push–Pull CMD. Set in order to drive the CMD wire via a push–
| | pull scheme, or leave clear to use open–drain for CMD transfers.
PD | 1 | Push–Pull Data. Set to drive data wires via a push–pull scheme,
| | or leave clear to use open–drain for data transfer.
W | 2 | Width. Controls how many data bits are used in any data trans-
| | action. Set to 0 to use DAT[0] only, 2’b01 to use DAT[3:0], and
| | 2’b10 to use DAT[7:0].
DS | 1 | Data strobe. Set to one to use the card’s data strobe, clear oth-
| | erwise. Parameters OPT EMMC and OPT DS must also be set to use
| | this capability.
DD | 1 | DDR. Set to one to transmit on both edges of the clock. Clear to
| | send one bit at a time on the positive edge of the clock only.
CKDIV | 8 | Clock division control. See Tbl. 5.7 for more information.

Table 5.6: PHY Front end configuration register fields

www.opencores.com | Rev. 1.0 | 24

CKDIV | Clock Frequency
8’h0 8’h1 8’h2 8’h3 8’h4 N Sets clock frequency to 25/ (N − 2) MHz. | 200 MHz clock. Requires OPT SERDES. 100 MHz clock. Requires OPT DDR. 50 MHz clock 25 MHz clock 12.5 MHz clock

Table 5.7: Clock division settings

The eMMC controller contains the option of using a data strobe to clock the return data. This requires OPT EMMC. This mode may be enabled in the PHY register. Doing so will force all data bits returned by the external device to be clocked using this return data strobe.
The SDIO/eMMC IO clock may be turned off when not in use. To turn this clock off, set the clock shutdown bit in the PHY register.
The LgBlk field sets the log, base two, of the any memory transfer size. The actual transfer length will be will be 2LGBLK bytes. The WB controller will not allow this to be set larger than the size of the FIFO, so any attempt to set this value past its maximum can be used to read back what the maximum value actually is.

## 5.5 Soft Resets

The controller may be reset at any time by writing a 32’h52000000 to the CMD register.
Any ongoing transactions will be canceled at that time and the controller will return immediately to idle.
Alternatively, a GO IDLE command may be sent at any time–even if a command response is pending or an IO operation is ongoing.
www.opencores.com | Rev. 1.0 | 25

6.

# Interrupts

An interrupt may be generated for any of the following reasons:

1. Any time a command completes, and any anticipated response is either returned or timed out. The exception to this rule is that no interrupt will be generated if subsequent IO to or from FIFOs is still pending and the command request completes without error.
2. Any time a sector if finished being sent to the device.
3. Any time a sector finishes being received by the device.
4. If the OPT CARD DETECT parameter is set, then an interrupt will be generated any time an acknowledged card is removed.
5. If the OPT CARD DETECT parameter is set, then an interrupt will also be generated any time a card is inserted. This interrupt, however, will only clear once the “Card removed” bit is also cleared.

All but the last of these reasons will generate a single interrupt pulse, one clock wide.

www.opencores.com | Rev. 1.0 | 26

7.

# Wishbone Datasheet

Tbl. 7.1 is required by the wishbone specification, and so it is included here. Note that all wishbone

Description | Specification
Revision level of wishbone | WB B4 spec
Type of interface | Slave, (Block/pipelined) Read/Write
Port size | 32–bit
Port granularity | 32–bit
Maximum Operand Size | 32–bit
Data transfer ordering | (Optional)
Clock constraints | (See below)
Signal Names | Signal Name Wishbone Equivalent i clk CLK I i wb cyc CYC I i wb stb STB I i wb we WE I i wb addr ADR I i wb data DAT I o wb ack ACK O o wb stall STALL O o wb data DAT O

Table 7.1: Wishbone Slave Datasheet

operations may be pipelined, to include FIFO operations, for speed.
The particular constraint on the clock is not really a wishbone constraint, but rather an SD–Card constraint. Not all cards can handle clocks faster than 25 MHz. For this reason, the wishbone clock, which forms the master clock for this entire controller, must be divided down so that the SPI clock is within the limits the card can handle.
www.opencores.com | Rev. 1.0 | 27

8.

# Clocks

All of the clocks within this system are based upon the speed of the system clock, i clk. This clock determines all other clock speeds within the design.
Name | Source | Rates (MHz) | Description
Max | Min
i clk i hsclk o ck | Input Input Output | 104 200 | 96 0.1 | System clock I/OSERDES clock. Must be 4x the i clk rate, and must come from the same PLL or MMCM as i clk. Only used if OPT SERDES is set so the design uses the 8x SERDES based front end. SDIO/eMMC interface clock. This signal is out-put over the interface at a frequency given by the clock divider controller. May also be turned off between commands.

The i clk speed has been nominally fixed at 100 MHz. Based upon this speed, the controller can generate 200 MHz, 100 MHz, and 50 MHz IO clocks. Other clocks may be generated by integer divisions of 50 MHz.

www.opencores.com | Rev. 1.0 | 28

9.

# I/O Ports

Table. 9.1 inputs and outputs are divided into sections: the master clock, the wishbone bus, the

Port | Width | Direction | Description
i clk | 1 | Input | System Clock, nominally 100 MHz
i hsclk | 1 | Input | SERDES Clock. Must be 4x the system clock.
i reset | 1 | Input | System reset. Active high.
WISHBONE | | | Wishbone bus slave signals
o ck | 1 | Output | SDIO/eMMC protocol clock signal
io cmd | 1 | In/Out | SDIO/eMMC command wire
io dat | NUMIO | In/Out | 1, 4, or 8 SDIO/eMMC data lines
i ds | 1 | Input | eMMC data strobe
i card detect | 1 | Input | High if the hardware detects a card, low o.w.
o 1p8v | 1 | Output | High if requesting 1.8 Volt IO. Requires OPT 1P8V be set.
o int | 1 | Output | An interrupt line to the CPU controller
o debug | 32 | Output | See Verilog for details

Table 9.1: List of IO ports

SDIO/eMMC interface to the card, and four other wires. Of these, the last two chapters discussed the wishbone bus interface and the clocks. The SDIO/eMMC interface should be fairly straightforward, so we’ll move on and discuss the other four wires.
The i card detect wire should come from any card detection circuitry if present. This is an active high input. If OPT CARD DETECT is set, this wire will be to set both the “Card not present” and “Card removed” bits.
The 1.8 Volt request line, o 1p8v, is used by the controller to indicate it’s desire to switch from 3.3 Volts to 1.8 Volts. The OPT 1P8V parameter should be set low if voltage switching is not supported.
The interrupt line, o int, has been discussed in Chapt. 6.
The final bus of 32–wires, o debug, is defined internally and used when/if necessary to debug the core and watch what is going on within it. These wires may be left unconnected in most implementations, as they are not necessary for using the actually controller.
www.opencores.com | Rev. 1.0 | 29
