SUAT-lhy/MEISHA-V100-A-Silicon-Proven-Quad-Core-RISC-V-SoC/trunk/hw/d2dv100_top/rtl/memory/memory_backups/test_ram/README.txt

===========================================================
icache新生成几组ram用于时序比对

(减小深度)
SYLB40_256X8X4CM4.v 单口，深度为256，bytes为4，256*8*4
SYLB40_256X8X4CM4_top.v 为顶层例化

(减小深度，且更换读取周期更短但面积更大的IP)
SQLVTLG40_256X8X4CM2b1.v 单口，深度为256，bytes为4，256*8*4
总线模式，无需顶层封装例化（文件名带有b1的为总线模式）

(更换读取周期更短但面积更大的IP)
SQLVTLG40_512X8X4CM4b1.v 单口，深度为512，bytes为4，512*8*4
总线模式，无需顶层封装例化

SJLA40_512X32X1CM4.v 双口，深度512，bytes为32，512*32*1
SJLA40_512X32X1CM4_top.v 为顶层例化

SYLB40_256X32X4CM2b1.v 单口，深度为256，bytes为32，256*32*4
总线模式，无需顶层封装例化

SYLB40_512X32X4CM2b1.v 单口，深度为512，bytes为32，512*32*4
总线模式，无需顶层封装例化

(更换读取周期更短但面积更大的IP)
SQLVTLG40_512X32X4CM2b1.v 单口，深度为512，bytes为32，512*32*4

===========================================================
icache新生成一组ram用于tag array优化面积

SYLB40_64X21X4CM2.v 单口，深度64，bytes为4，64*21*4
SYLB40_64X21X4CM2_top.v 为顶层例化

===========================================================
dcache新生成几组ram用于时序比对

(减小深度)
SYLB40_256X8X8CM2.v 单口，深度256，bytes为8，256*8*8
SYLB40_256X8X8CM2_top.v 为顶层例化

(减小深度，且更换读取周期更短但面积更大的IP)
SQLVTLG40_256X8X8CM2b1.v 单口，深度256，bytes为8，256*8*8
总线模式，无需顶层封装例化

(更换读取周期更短但面积更大的IP)
SQLVTLG40_512X8X8CM4b1.v 单口，深度512，bytes为8，512*8*8
总线模式，无需顶层封装例化

===========================================================
dcache新生成一组ram用于tag array优化面积

SYLB40_64X22X4CM2.v 单口，深度64，bytes为4，64*22*4
SYLB40_64X22X4CM2_top.v 为顶层例化

===========================================================

sram
SHLB40_8192X8X8CM8.v 单口ram，大小为8192 * 64，bytes为8
SHLB40_8192X8X8CM8_top.v 为顶层例化
===========================================================
