SUAT-lhy/MEISHA-V100-A-Silicon-Proven-Quad-Core-RISC-V-SoC/trunk/hw/ip/sdspi/bench/verilog/sdio_testcases.txt

################################################################################
##
## Filename: 	sdio_testcases.txt
## {{{
## Project:	SD-Card controller, using a shared SPI interface
##
## Purpose:	Defines a set of tests to be applied to the SDIO (not the eMMC)
##		controller and simulation model.
##
## Creator:	Dan Gisselquist, Ph.D.
##		Gisselquist Technology, LLC
##
################################################################################
## }}}
## Copyright (C) 2023, Gisselquist Technology, LLC
## {{{
## This program is free software (firmware): you can redistribute it and/or
## modify it under the terms of the GNU General Public License as published
## by the Free Software Foundation, either version 3 of the License, or (at
## your option) any later version.
##
## This program is distributed in the hope that it will be useful, but WITHOUT
## ANY WARRANTY; without even the implied warranty of MERCHANTIBILITY or
## FITNESS FOR A PARTICULAR PURPOSE.  See the GNU General Public License
## for more details.
##
## You should have received a copy of the GNU General Public License along
## with this program.  (It's in the $(ROOT)/doc directory.  Run make with no
## target there if the PDF file isn't present.)  If not, see
## <http://www.gnu.org/licenses/> for a copy.
## }}}
## License:	GPL, v3, as defined and found on www.gnu.org,
## {{{
##		http://www.gnu.org/licenses/gpl.html
##
##
################################################################################
##
## Format:
##  Test name | Test script | (PARAM=X)*
## }}}
sdioio	sdiostart	OPT_SERDES=0 OPT_DDR=0
#sdioddr	sdiostart	OPT_SERDES=0 OPT_DDR=1
#sdio8x	sdiostart	OPT_SERDES=1 OPT_DDR=1
