SUAT-lhy/MEISHA-V100-A-Silicon-Proven-Quad-Core-RISC-V-SoC/trunk/hw/ip/block-nvdla-sifive/hw/perf/NVDLA_OpenSource_Performance.xlsx

Sheet: Readme
Purpose of the spreadsheet | This spreadsheet should be used to determine the performance of the NVDLA Open Source Hardware
How to use the sheet | The "Configuration Input" sheet exposes the hardware parameters for the configuration of interest. Fill in your configuration settings and view the resulting performance in the "Performance Sumary" sheet. This sheet supports several very common CNN Networks. Additional sheets can be added in a similar fashon to estimate performance on other convolutional networks.
Assumption/Limitation:
1 | This spreadsheet calculates optimal performance, not including software overhead and mode switch time
2 | In this spreadsheet we assume most of the Pooling/Scaling/Element-wise-op can be fused together with convolutional layers, so those layers doesn't show up in the performance calculations. This fusing results from multiple hardware units in NVDLA running in parallel.
3 | We assume the primary memory interface will be connected to DRAM, and Second Memory Interface connected to on-chip SRAM. So the Primary Memory Bandwidth is combined for both read and write, while we have separated read and write bandwidth limitations for the second memory interface
4 | There are two different MAC utilization measurements: HW MAC Utilization reflects the percentage of MAC cells busy on average; and Network MAC Utilization reflects the overall functional utilization comparing to non-optimized function. As NVDLA implements optimization features like Winograd, the network MAC Utilization is expected to be better than HW MAC Utilization.
5 | For AlexNet we also create a performance result in case that NVDLA has a second memory interface instanced, the performance is getting improved significantly
Supported Networks:
AlexNet
GoogleNet
ResNet50
Hardware Configuration Parameters | Description | Available Value
Input Data type (Byte) | Input feature data type | 1 Byte, 2 Byte
Weight Data Type (Byte) | Weight data type | 1 Byte, 2 Byte
Convolution input buffer (KB) | Size of the shared convolutional buffer, which is used for both feature data and weight data | 32KB, 64KB, 128KB, 256KB, 512KB
MAC Number | Number of MAC resources. Note that the MAC type should match the feature/weight data type | 32, 64, 128, 256, 512, 1024, 2048
Clock Frequency | Clock Frequence of NVDLA Core Logic
Secondary Mem Interface Read BW Limitation (GB/s) | Memory read bandwidth of secondary memory interface
Secondary Mem Interface Write BW Limitation (GB/s) | Memory write bandwidth of the secondary memory interface
Primary Memory Interface BW Limitation (GB/s) | Memory read + write bandwidth on primary memory interface.
FC batch size | Batch size -- only for fully-connected layers | 1~16
Calculated Performance Metrics | Description
Average run time for one frame | Average run time for a single frame. For a batch of frames, it reflect the time of BATCH_RUNTIME/BATCH_NUM
FPS | Frames Per Second
HW MAC Utilization | Hardware MAC Utilization, equation as MAC_BUSY_CYCLE/TOTAL_CYCLE
Network MAC Utilization | Network MAC Utilization, equation as NETWORK_MAC_NUMBER/MAC_NUMBER/TOTAL_CYCLE. This metrics accounts for winograd improvement over basic convolution.

Sheet: Configuration Input
Configuration Inputs
Feature Data Size (Byte) | Weight Data Size (Byte) | Convolutional Buffer Size (KB) | MAC Number | Clock Frequency (MHz) | Secondary Mem Interface Read BW Limitation (GB/s) | Secondary Mem Interface Write BW Limitation (GB/s) | Primary DBB BW Limitation (GB/s) | Fully-Connected Layer Batch Size
1 | 1 | 512 | 2048 | 1000MHz | 25GB/s | 25GB/s | 10GB/s | 16

Sheet: Performance Summary
Perf Results
Network | Average Run Time for 1 Frame | FPS | HW MAC Utilization | Network MAC Utilization
AlexNet (with 4M on-chip SRAM through 2nd MEM I.F.) | 0.59ms | 1690.69 | 44.06% | 59.80%
AlexNet | 0.90ms | 1116.76 | 29.10% | 39.50%
GoogLeNet | 1.22ms | 818.28 | 43.19% | 62.72%
ResNet50 | 7.11ms | 140.57 | 23.16% | 26.75%

Sheet: AlexNet
Input Data type (Byte) | 1
Weight Data Type (Byte) | 1 |  | Compression rate | 0.00%
Convolution input buffer (KB) | 512
Number of Multiplier(16bit) | 2048
Frequency | 1000MHz
CVSRAM read BW limitation | 25GBps
CVSRAM write BW Limitation | 25GBps
DRAM BW Limitation | 10GBps |  |  |  |  |  |  |  |  |  |  |  |  |  |  |  |  |  |  |  |  |  |  |  |  |  |  |  | SRAM=4M |  |  |  |  |  |  |  |  | SRAM=0M
FC batch size | 16 |  |  |  |  |  |  |  |  |  |  |  |  |  |  |  |  |  |  |  |  |  |  |  |  |  |  |  |  |  |  |  | 4096
Net | Layer | Layer attribute | #input feature maps C | Input Height H | Input Width W | #output feature maps K | Filter Height R | Filter Width S | Zero Padding Z | Vertical Conv Srtide H | Horizontal Conv Stride V | Height after Conv P | Width after Conv Q | Pooling after Conv | Pooling Height D | Pooling Width E | Vertical pooling stride F | Horizontal pooling stride G | Height after Pooling A | Height after Pooling B | Calculation | Input data size | Min input data size | Output data size | Weight data size | Min weight data size | Winograd | SRAM Batching size | DRAM Traffic | DRAM Cycles | SRAM Read Traffic | SRAM Read Cycles | CRAM Write Traffic | SRAM Write Cycles | MAC cycles | MAX Cycles | Long Pole | Conv Batch | DRAM Traffic | DRAM Cycles | MAC Cycles | MAX Cycle | Long Pole
Alexnet in Caffe | 1 | conv | 3 | 224 | 224 | 96 | 11 | 11 | FALSE | 4 | 4 | 55 | 55 | TRUE | 3 | 3 | 2 | 2 | 27 | 27 | 105415200 | 147KB | 31.5KB | 68.34375KB | 40.5KB | 13.5KB | FALSE | 18 | 149.25KB | 14925 | 0KB | 0 | 68.34375KB | 2734 | 49617.5625 | 49617.5625 | MAC | 1 | 255.84375KB | 25585 | 49617.5625 | 49617.5625 | MAC
Alexnet in Caffe | 2 | conv | 48 | 27 | 27 | 128 | 5 | 5 | TRUE | 1 | 1 | 27 | 27 | TRUE | 3 | 3 | 2 | 2 | 13 | 13 | 111974400 | 34.171875KB | 7.59375KB | 21.125KB | 150KB | 37.5KB | FALSE | 71 | 9.375KB | 938 | 34.171875KB | 1367 | 21.125KB | 845 | 54675 | 54675 | MAC | 1 | 205.296875KB | 20530 | 54675 | 54675 | MAC
Alexnet in Caffe | 2 | conv | 48 | 27 | 27 | 128 | 5 | 5 | TRUE | 1 | 1 | 27 | 27 | TRUE | 3 | 3 | 2 | 2 | 13 | 13 | 111974400 | 34.171875KB | 7.59375KB | 21.125KB | 150KB | 37.5KB | FALSE | 71 | 8.333333333KB | 834 | 34.171875KB | 1367 | 21.125KB | 845 | 54675 | 54675 | MAC | 1 | 205.296875KB | 20530 | 54675 | 54675 | MAC
Alexnet in Caffe | 3 | conv | 256 | 13 | 13 | 384 | 3 | 3 | TRUE | 1 | 1 | 13 | 13 | FALSE |  |  |  |  | 13 | 13 | 149520384 | 42.25KB | 13KB | 63.375KB | 1536KB | 72KB | TRUE | 24 | 85.33333333KB | 8534 | 42.25KB | 1690 | 63.375KB | 2535 | 32448 | 32448 | MAC | 1 | 1641.625KB | 164163 | 32448 | 164163 | DRAM
Alexnet in Caffe | 4 | conv | 192 | 13 | 13 | 192 | 3 | 3 | TRUE | 1 | 1 | 13 | 13 | FALSE |  |  |  |  | 13 | 13 | 56070144 | 31.6875KB | 9.75KB | 31.6875KB | 576KB | 54KB | TRUE | 55 | 32KB | 3200 | 31.6875KB | 1268 | 31.6875KB | 1268 | 12168 | 12168 | MAC | 1 | 639.375KB | 63938 | 12168 | 63938 | DRAM
Alexnet in Caffe | 4 | conv | 192 | 13 | 13 | 192 | 3 | 3 | TRUE | 1 | 1 | 13 | 13 | FALSE |  |  |  |  | 13 | 13 | 56070144 | 31.6875KB | 9.75KB | 31.6875KB | 576KB | 54KB | TRUE | 55 | 32KB | 3200 | 31.6875KB | 1268 | 31.6875KB | 1268 | 12168 | 12168 | MAC | 1 | 639.375KB | 63938 | 12168 | 63938 | DRAM
Alexnet in Caffe | 5 | conv | 192 | 13 | 13 | 128 | 3 | 3 | TRUE | 1 | 1 | 13 | 13 | TRUE | 3 | 3 | 2 | 2 | 6 | 6 | 37380096 | 31.6875KB | 9.75KB | 4.5KB | 384KB | 54KB | TRUE | 102 | 25.83333333KB | 2584 | 31.6875KB | 1268 | 4.5KB | 180 | 8112 | 8112 | MAC | 1 | 420.1875KB | 42019 | 8112 | 42019 | DRAM
Alexnet in Caffe | 5 | conv | 192 | 13 | 13 | 128 | 3 | 3 | TRUE | 1 | 1 | 13 | 13 | TRUE | 3 | 3 | 2 | 2 | 6 | 6 | 37380096 | 31.6875KB | 9.75KB | 4.5KB | 384KB | 54KB | TRUE | 102 | 25.83333333KB | 2584 | 31.6875KB | 1268 | 4.5KB | 180 | 8112 | 8112 | MAC | 1 | 420.1875KB | 42019 | 8112 | 42019 | DRAM
Alexnet in Caffe | fc1 | fc | 256 | 6 | 6 | 4096 | 6 | 6 | FALSE | 1 | 1 | 1 | 1 | FALSE |  |  |  |  | 1 | 1 | 37748736 | 9KB | 9KB | 4KB | 36864KB | 288KB | FALSE |  | 2313KB | 231300 | 9KB | 360 | 4KB | 160 | 18432 | 231300 | DRAM | 1 | 2317KB | 231700 | 18432 | 231700 | DRAM
Alexnet in Caffe | fc2 | fc | 4096 | 1 | 1 | 4096 | 1 | 1 | FALSE | 1 | 1 | 1 | 1 | FALSE |  |  |  |  | 1 | 1 | 16777216 | 4KB | 4KB | 4KB | 16384KB | 128KB | FALSE |  | 1028KB | 102800 | 4KB | 160 | 4KB | 160 | 8192 | 102800 | DRAM | 1 | 1032KB | 103200 | 8192 | 103200 | DRAM
Alexnet in Caffe | fc3 | fc | 4096 | 1 | 1 | 1000 | 1 | 1 | FALSE | 1 | 1 | 1 | 1 | FALSE |  |  |  |  | 1 | 1 | 4096000 | 4KB | 4KB | 0.984375KB | 4000KB | 128KB | FALSE |  | 254KB | 25400 | 4KB | 160 | 0.984375KB | 40 | 2000 | 25400 | DRAM | 1 | 254.984375KB | 25499 | 2000 | 25499 | DRAM
Alexnet in Caffe |  |  |  |  |  |  |  |  |  |  |  |  |  |  |  |  |  |  |  |  |  |  |  |  |  |  |  |  |  |  |  |  |  |  | Total Cycle | 591475.5625 |  |  |  |  | Total Cycle | 895443.5625
Alexnet in Caffe | total |  |  |  |  |  |  |  |  |  |  |  |  |  |  |  |  |  |  |  |  |  |  |  |  |  |  |  |  |  |  |  |  |  | Total Time | 0.5914755625 | ms |  |  |  | Total Time | 0.8954435625MHz | ms
Alexnet in Caffe |  |  |  |  |  |  |  |  |  |  |  |  |  |  |  |  |  |  |  |  |  |  |  |  |  |  |  |  |  |  |  |  |  |  | FPS | 1690.686925 | FPS |  |  |  | FPS | 1116.764966 | FPS
 |  |  |  |  |  |  |  |  |  |  |  |  |  |  |  |  |  |  |  |  |  |  |  |  |  |  |  |  |  |  |  |  |  |  | HW MAC Effi | 44.06% |  |  |  |  | HW MAC Effi | 29.10%
 |  |  |  |  |  |  |  |  |  |  |  |  |  |  |  |  |  |  |  |  |  |  |  |  |  |  |  |  |  |  |  |  |  |  | Network MAC Effi | 59.80% |  |  |  |  | Network MAC Effi | 39.50%

Sheet: GoogLeNet
Input Data type (Byte) | 1
Weight Data Type (Byte) | 1 |  | Compression Rate | 0.00%
Convolution input buffer (KB) | 512
Number of Multiplier(16bit) | 2048
Frequency | 1000MHz
CVSRAM read BW limitation | 25GBps
CVSRAM write BW Limitation | 25GBps
DRAM BW Limitation | 10GBps |  |  |  |  |  |  |  |  |  |  |  |  |  |  |  |  |  |  |  |  |  |  |  |  |  |  |  | CVSRAM=4M |  |  |  |  |  |  |  |  |  |  | SRAM=0M
FC batch size | 16 |  |  |  |  |  |  |  |  |  |  |  |  |  |  |  |  |  |  |  |  |  |  |  |  |  |  |  |  |  |  |  | 4096 | 512
Net | Layer | Layer attribute | #input feature maps C | Input Height H | Input Width W | #output feature maps K | Filter Height R | Filter Width S | Zero Padding Z | Vertical Conv Srtide H | Horizontal Conv Stride V | Height after Conv P | Width after Conv Q | Pooling after Conv | Pooling Height D | Pooling Width E | Vertical pooling stride F | Horizontal pooling stride G | Height after Pooling A | Height after Pooling B | Calculation | Input data size | Min input data | Output data size | Weight data size | min weight data | Winograd? | CVSRAM Batching size | DRAM Traffic | DRAM Cycles | CVSRAM Read Traffic | CVSRAM Read Cycles | CVSRAM Write Traffic | CVSRAM Write Cycles | MAC cycles | MAX Cycles | Long Pole | Smaller size | Factor | DRAM Traffic | DRAM Cycles | MAC Cycles | MAX Cycle | Long Pole
GoogLeNet | conv1 | conv | 3 | 224 | 224 | 64 | 7 | 7 | TRUE | 2 | 2 | 112 | 112 | TRUE | 3 | 3 | 2 | 2 | 56 | 56 | 118013952 | 196KB | 14KB | 196KB | 16KB | 8KB | FALSE | 6 | 198.6666667KB | 19867 | 198.6666667KB | 7947 | 196KB | 7840 | 76832 | 76832 | MAC | weight | 1 | 408KB | 40800 | 76832 | 76832 | MAC
GoogLeNet | conv2 | conv | 64 | 56 | 56 | 192 | 3 | 3 | TRUE | 1 | 1 | 56 | 56 | TRUE | 3 | 3 | 2 | 2 | 28 | 28 | 346816512 | 196KB | 14KB | 147KB | 192KB | 18KB | TRUE | 6 | 179KB | 17900 | 228KB | 9120 | 147KB | 5880 | 75264 | 75264 | MAC | weight | 1 | 535KB | 53500 | 75264 | 75264 | MAC
GoogLeNet | inception 3a 1x1 | conv | 192 | 28 | 28 | 64 | 1 | 1 | TRUE | 1 | 1 | 28 | 28 | FALSE |  |  |  |  | 28 | 28 | 9633792 | 147KB | 10.5KB | 49KB | 12KB | 6KB | FALSE | 16 | 1.090909091KB | 110 | 147KB | 5880 | 49KB | 1960 |  |  |  | weight | 1 | 208KB | 20800
GoogLeNet | inception 3a 3x3 red | conv | 192 | 28 | 28 | 96 | 1 | 1 | TRUE | 1 | 1 | 28 | 28 | FALSE |  |  |  |  | 28 | 28 | 14450688 | 147KB | 10.5KB | 73.5KB | 18KB | 6KB | FALSE | 16 | 1.636363636KB | 164 | 147KB | 5880 | 73.5KB | 2940 |  |  |  | weight | 1 | 238.5KB | 23850
GoogLeNet | inception 3a 5x5 red | conv | 192 | 28 | 28 | 16 | 1 | 1 | TRUE | 1 | 1 | 28 | 28 | FALSE |  |  |  |  | 28 | 28 | 2408448 | 147KB | 10.5KB | 12.25KB | 3KB | 6KB | FALSE | 16 | 0.2727272727KB | 28 | 147KB | 5880 | 12.25KB | 490 |  |  |  | weight | 1 | 162.25KB | 16225
GoogLeNet | Inception 3a 1x1 (combined) | conv | 192 | 28 | 28 | 176 | 1 | 1 | TRUE | 1 | 1 | 28 | 28 | FALSE |  |  |  |  | 28 | 28 |  | 147KB | 10.5KB | 134.75KB | 33KB | 6KB | FALSE | 16 | 3KB | 300 | 147KB | 5880 | 134.75KB | 5390 | 12936 | 12936 | MAC | weight | 1 | 314.75KB | 31475 | 12936 | 31475 | DRAM
GoogLeNet | inception 3a 3x3 | conv | 96 | 28 | 28 | 128 | 3 | 3 | TRUE | 1 | 1 | 28 | 28 | FALSE |  |  |  |  | 28 | 28 | 86704128 | 73.5KB | 10.5KB | 98KB | 192KB | 27KB | TRUE | 16 | 17.45454545KB | 1746 | 265.5KB | 10620 | 98KB | 3920 | 18816 | 18816 | MAC | weight | 1 | 363.5KB | 36350 | 18816 | 36350 | DRAM
GoogLeNet | inception 3a 5x5 | conv | 16 | 28 | 28 | 32 | 5 | 5 | TRUE | 1 | 1 | 28 | 28 | FALSE |  |  |  |  | 28 | 28 | 10035200 | 12.25KB | 2.625KB | 24.5KB | 12.5KB | 12.5KB | FALSE | 16 | 25.63636364KB | 2564 | 24.75KB | 990 | 24.5KB | 980 | 4900 | 4900 | MAC | feature | 1 | 49.25KB | 4925 | 4900 | 4925 | DRAM
GoogLeNet | inception 3a pool proj | conv | 192 | 28 | 28 | 32 | 1 | 1 | TRUE | 1 | 1 | 28 | 28 | FALSE |  |  |  |  | 28 | 28 | 4816896 | 147KB | 10.5KB | 24.5KB | 6KB | 6KB | FALSE | 16 | 25.04545455KB | 2505 | 153KB | 6120 | 24.5KB | 980 | 2352 | 6120 | CVSRAM-R | weight | 1 | 177.5KB | 17750 | 2352 | 17750 | DRAM
GoogLeNet | inception 3a DRAM |  |  |  |  |  |  |  |  |  |  |  |  |  |  |  |  |  |  |  |  |  |  |  |  |  |  |  | 365.1363636KB | 36514 |  |  |  |  |  | 0 | NONE |  | 1
GoogLeNet | inception 3b 1x1 | conv | 256 | 28 | 28 | 128 | 1 | 1 | TRUE | 1 | 1 | 28 | 28 | FALSE |  |  |  |  | 28 | 28 | 25690112 | 196KB | 14KB | 98KB | 32KB | 8KB | FALSE | 11 | 2.909090909KB | 291 | 196KB | 7840 | 98KB | 3920 |  |  |  | weight | 1 | 326KB | 32600
GoogLeNet | inception 3b 3x3 red | conv | 256 | 28 | 28 | 128 | 1 | 1 | TRUE | 1 | 1 | 28 | 28 | FALSE |  |  |  |  | 28 | 28 | 25690112 | 196KB | 14KB | 98KB | 32KB | 8KB | FALSE | 11 | 2.909090909KB | 291 | 196KB | 7840 | 98KB | 3920 |  |  |  | weight | 1 | 326KB | 32600
GoogLeNet | inception 3b 5x5 red | conv | 256 | 28 | 28 | 32 | 1 | 1 | TRUE | 1 | 1 | 28 | 28 | FALSE |  |  |  |  | 28 | 28 | 6422528 | 196KB | 14KB | 24.5KB | 8KB | 8KB | FALSE | 11 | 0.7272727273KB | 73 | 196KB | 7840 | 24.5KB | 980 |  |  |  | weight | 1 | 228.5KB | 22850
GoogLeNet | Inception 3b 1x1 (combined) | conv | 256 | 28 | 28 | 288 | 1 | 1 | TRUE | 1 | 1 | 28 | 28 | FALSE |  |  |  |  | 28 | 28 |  | 196KB | 14KB | 220.5KB | 72KB | 8KB | FALSE | 11 | 196KB | 19600 | 72KB | 2880 | 220.5KB | 8820 | 28224 | 28224 | MAC | weight | 1 | 488.5KB | 48850 | 28224 | 48850 | DRAM
GoogLeNet | inception 3b 3x3 | conv | 128 | 28 | 28 | 192 | 3 | 3 | TRUE | 1 | 1 | 28 | 28 | FALSE |  |  |  |  | 28 | 28 | 173408256 | 98KB | 14KB | 147KB | 216KB | 36KB | TRUE | 11 | 147KB | 14700 | 314KB | 12560 | 0KB | 0 | 37632 | 37632 | MAC | weight | 1 | 461KB | 46100 | 37632 | 46100 | DRAM
GoogLeNet | inception 3b 5x5 | conv | 32 | 28 | 28 | 96 | 5 | 5 | TRUE | 1 | 1 | 28 | 28 | FALSE |  |  |  |  | 28 | 28 | 60211200 | 24.5KB | 5.25KB | 73.5KB | 75KB | 25KB | FALSE | 11 | 73.5KB | 7350 | 99.5KB | 3980 | 0KB | 0 | 29400 | 29400 | MAC | feature | 1 | 173KB | 17300 | 29400 | 29400 | MAC
GoogLeNet | inception 3b pool proj | conv | 256 | 28 | 28 | 64 | 1 | 1 | TRUE | 1 | 1 | 28 | 28 | TRUE | 3 | 3 | 2 | 2 | 14 | 14 | 12845056 | 196KB | 14KB | 12.25KB | 16KB | 8KB | FALSE | 11 | 12.25KB | 1225 | 212KB | 8480 | 12.25KB | 490 | 6272 | 8480 | CVSRAM-R | weight | 1 | 224.25KB | 22425 | 6272 | 22425 | DRAM
GoogLeNet | inception 3b DRAM |  |  |  |  |  |  |  |  |  |  |  |  |  |  |  |  |  |  |  |  |  |  |  |  |  |  |  | 561.2045455KB | 56121 |  |  |  |  |  | 0 | NONE |  | 1
GoogLeNet | inception 4a 1x1 | conv | 480 | 14 | 14 | 192 | 1 | 1 | TRUE | 1 | 1 | 14 | 14 | FALSE |  |  |  |  | 14 | 14 | 18063360 | 91.875KB | 13.125KB | 36.75KB | 90KB | 15KB | FALSE | 31 | 8.181818182KB | 819 | 91.875KB | 3675 | 36.75KB | 1470 |  |  |  | weight | 1 | 218.625KB | 21863
GoogLeNet | inception 4a 3x3 red | conv | 480 | 14 | 14 | 96 | 1 | 1 | TRUE | 1 | 1 | 14 | 14 | FALSE |  |  |  |  | 14 | 14 | 9031680 | 91.875KB | 13.125KB | 18.375KB | 45KB | 15KB | FALSE | 31 | 4.090909091KB | 410 | 91.875KB | 3675 | 18.375KB | 735 |  |  |  | weight | 1 | 155.25KB | 15525
GoogLeNet | inception 4a 5x5 red | conv | 480 | 14 | 14 | 16 | 1 | 1 | TRUE | 1 | 1 | 14 | 14 | FALSE |  |  |  |  | 14 | 14 | 1505280 | 91.875KB | 13.125KB | 3.0625KB | 7.5KB | 15KB | FALSE | 31 | 0.6818181818KB | 69 | 91.875KB | 3675 | 3.0625KB | 123 |  |  |  | weight | 1 | 102.4375KB | 10244
GoogLeNet | Inception 4a 1x1 (combined) | conv | 480 | 14 | 14 | 304 | 1 | 1 | TRUE | 1 | 1 | 14 | 14 | FALSE |  |  |  |  | 14 | 14 |  | 91.875KB | 13.125KB | 58.1875KB | 142.5KB | 15KB | FALSE | 31 | 12.95454545KB | 1296 | 91.875KB | 3675 | 58.1875KB | 2328 | 13965 | 13965 | MAC | weight | 1 | 292.5625KB | 29257 | 13965 | 29257 | DRAM
GoogLeNet | inception 4a 3x3 | conv | 96 | 14 | 14 | 208 | 3 | 3 | TRUE | 1 | 1 | 14 | 14 | FALSE |  |  |  |  | 14 | 14 | 35223552 | 18.375KB | 5.25KB | 39.8125KB | 175.5KB | 27KB | TRUE | 31 | 15.95454545KB | 1596 | 193.875KB | 7755 | 39.8125KB | 1593 | 7644 | 7755 | CVSRAM-R | feature | 1 | 233.6875KB | 23369 | 7644 | 23369 | DRAM
GoogLeNet | inception 4a 5x5 | conv | 16 | 14 | 14 | 48 | 5 | 5 | TRUE | 1 | 1 | 14 | 14 | FALSE |  |  |  |  | 14 | 14 | 3763200 | 3.0625KB | 1.3125KB | 9.1875KB | 18.75KB | 12.5KB | FALSE | 31 | 1.704545455KB | 171 | 21.8125KB | 873 | 9.1875KB | 368 | 1837.5 | 1837.5 | MAC | feature | 1 | 31KB | 3100 | 1837.5 | 3100 | DRAM
GoogLeNet | inception 4a pool proj | conv | 480 | 14 | 14 | 64 | 1 | 1 | TRUE | 1 | 1 | 14 | 14 | FALSE |  |  |  |  | 14 | 14 | 6021120 | 91.875KB | 13.125KB | 12.25KB | 30KB | 15KB | FALSE | 31 | 2.727272727KB | 273 | 121.875KB | 4875 | 12.25KB | 490 | 2940 | 4875 | CVSRAM-R | weight | 1 | 134.125KB | 13413 | 2940 | 13413 | DRAM
 |  |  |  |  |  |  |  |  |  |  |  |  |  |  |  |  |  |  |  |  |  |  |  |  |  |  |  |  | 223.2159091KB | 22322 |  |  |  |  |  | 0 | NONE |  | 1
GoogLeNet | inception 4b 1x1 | conv | 512 | 14 | 14 | 160 | 1 | 1 | TRUE | 1 | 1 | 14 | 14 | FALSE |  |  |  |  | 14 | 14 | 16056320 | 98KB | 14KB | 30.625KB | 80KB | 16KB | FALSE | 27 | 7.272727273KB | 728 | 98KB | 3920 | 30.625KB | 1225 |  |  |  | weight | 1 | 208.625KB | 20863
GoogLeNet | inception 4b 3x3 red | conv | 512 | 14 | 14 | 112 | 1 | 1 | TRUE | 1 | 1 | 14 | 14 | FALSE |  |  |  |  | 14 | 14 | 11239424 | 98KB | 14KB | 21.4375KB | 56KB | 16KB | FALSE | 27 | 5.090909091KB | 510 | 98KB | 3920 | 21.4375KB | 858 |  |  |  | weight | 1 | 175.4375KB | 17544
GoogLeNet | inception 4b 5x5 red | conv | 512 | 14 | 14 | 24 | 1 | 1 | TRUE | 1 | 1 | 14 | 14 | FALSE |  |  |  |  | 14 | 14 | 2408448 | 98KB | 14KB | 6.125KB | 12KB | 16KB | FALSE | 27 | 1.090909091KB | 110 | 98KB | 3920 | 6.125KB | 245 |  |  |  | weight | 1 | 116.125KB | 11613
GoogLeNet | Inception 4b 1x1 (combined) | conv | 512 | 14 | 14 | 296 | 1 | 1 | TRUE | 1 | 1 | 14 | 14 | FALSE |  |  |  |  | 14 | 14 |  | 98KB | 14KB | 58.1875KB | 148KB | 16KB | FALSE | 27 | 13.45454545KB | 1346 | 98KB | 3920 | 58.1875KB | 2328 | 14896 | 14896 | MAC | weight | 1 | 304.1875KB | 30419 | 14896 | 30419 | DRAM
GoogLeNet | inception 4b 3x3 | conv | 112 | 14 | 14 | 224 | 3 | 3 | TRUE | 1 | 1 | 14 | 14 | FALSE |  |  |  |  | 14 | 14 | 44255232 | 21.4375KB | 6.125KB | 42.875KB | 220.5KB | 31.5KB | TRUE | 27 | 20.04545455KB | 2005 | 241.9375KB | 9678 | 42.875KB | 1715 | 9604 | 9678 | CVSRAM-R | feature | 1 | 284.8125KB | 28482 | 9604 | 28482 | DRAM
GoogLeNet | inception 4b 5x5 | conv | 24 | 14 | 14 | 64 | 5 | 5 | TRUE | 1 | 1 | 14 | 14 | FALSE |  |  |  |  | 14 | 14 | 7526400 | 6.125KB | 2.625KB | 12.25KB | 50KB | 25KB | FALSE | 27 | 4.545454545KB | 455 | 56.125KB | 2245 | 12.25KB | 490 | 4900 | 4900 | MAC | feature | 1 | 68.375KB | 6838 | 4900 | 6838 | DRAM
GoogLeNet | inception 4b pool proj | conv | 512 | 14 | 14 | 64 | 1 | 1 | TRUE | 1 | 1 | 14 | 14 | FALSE |  |  |  |  | 14 | 14 | 6422528 | 98KB | 14KB | 12.25KB | 32KB | 16KB | FALSE | 27 | 2.909090909KB | 291 | 130KB | 5200 | 12.25KB | 490 | 3136 | 5200 | CVSRAM-R | weight | 1 | 142.25KB | 14225 | 3136 | 14225 | DRAM
 |  |  |  |  |  |  |  |  |  |  |  |  |  |  |  |  |  |  |  |  |  |  |  |  |  |  |  |  | 236.9545455KB | 23696 |  |  |  |  |  | 0 | NONE |  | 1
GoogLeNet | inception 4c 1x1 | conv | 512 | 14 | 14 | 128 | 1 | 1 | TRUE | 1 | 1 | 14 | 14 | FALSE |  |  |  |  | 14 | 14 | 12845056 | 98KB | 14KB | 24.5KB | 64KB | 16KB | FALSE | 26 | 5.818181818KB | 582 | 98KB | 3920 | 24.5KB | 980 |  |  |  | weight | 1 | 186.5KB | 18650
GoogLeNet | inception 4c 3x3 red | conv | 512 | 14 | 14 | 128 | 1 | 1 | TRUE | 1 | 1 | 14 | 14 | FALSE |  |  |  |  | 14 | 14 | 12845056 | 98KB | 14KB | 24.5KB | 64KB | 16KB | FALSE | 26 | 5.818181818KB | 582 | 98KB | 3920 | 24.5KB | 980 |  |  |  | weight | 1 | 186.5KB | 18650
GoogLeNet | inception 4c 5x5 red | conv | 512 | 14 | 14 | 24 | 1 | 1 | TRUE | 1 | 1 | 14 | 14 | FALSE |  |  |  |  | 14 | 14 | 2408448 | 98KB | 14KB | 6.125KB | 12KB | 16KB | FALSE | 26 | 1.090909091KB | 110 | 98KB | 3920 | 6.125KB | 245 |  |  |  | weight | 1 | 116.125KB | 11613
GoogLeNet | Inception 4c 1x1 (combined) | conv | 512 | 14 | 14 | 280 | 1 | 1 | TRUE | 1 | 1 | 14 | 14 | FALSE |  |  |  |  | 14 | 14 |  | 98KB | 14KB | 55.125KB | 140KB | 16KB | FALSE | 26 | 12.72727273KB | 1273 | 98KB | 3920 | 55.125KB | 2205 | 14112 | 14112 | MAC | weight | 1 | 293.125KB | 29313 | 14112 | 29313 | DRAM
GoogLeNet | inception 4c 3x3 | conv | 128 | 14 | 14 | 256 | 3 | 3 | TRUE | 1 | 1 | 14 | 14 | FALSE |  |  |  |  | 14 | 14 | 57802752 | 24.5KB | 7KB | 49KB | 288KB | 36KB | TRUE | 26 | 26.18181818KB | 2619 | 312.5KB | 12500 | 49KB | 1960 | 12544 | 12544 | MAC | feature | 1 | 361.5KB | 36150 | 12544 | 36150 | DRAM
GoogLeNet | inception 4c 5x5 | conv | 24 | 14 | 14 | 64 | 5 | 5 | TRUE | 1 | 1 | 14 | 14 | FALSE |  |  |  |  | 14 | 14 | 7526400 | 6.125KB | 2.625KB | 12.25KB | 50KB | 25KB | FALSE | 26 | 4.545454545KB | 455 | 56.125KB | 2245 | 12.25KB | 490 | 4900 | 4900 | MAC | feature | 1 | 68.375KB | 6838 | 4900 | 6838 | DRAM
GoogLeNet | inception 4c pool proj | conv | 512 | 14 | 14 | 64 | 1 | 1 | TRUE | 1 | 1 | 14 | 14 | FALSE |  |  |  |  | 14 | 14 | 6422528 | 98KB | 14KB | 12.25KB | 32KB | 16KB | FALSE | 26 | 2.909090909KB | 291 | 130KB | 5200 | 12.25KB | 490 | 3136 | 5200 | CVSRAM-R | weight | 1 | 142.25KB | 14225 | 3136 | 14225 | DRAM
 |  |  |  |  |  |  |  |  |  |  |  |  |  |  |  |  |  |  |  |  |  |  |  |  |  |  |  |  | 242.3636364KB | 24237 |  |  |  |  |  | 0 | NONE |  | 1
GoogLeNet | inception 4d 1x1 | conv | 512 | 14 | 14 | 112 | 1 | 1 | TRUE | 1 | 1 | 14 | 14 | FALSE |  |  |  |  | 14 | 14 | 11239424 | 98KB | 14KB | 21.4375KB | 56KB | 16KB | FALSE | 25 | 5.090909091KB | 510 | 98KB | 3920 | 21.4375KB | 858 |  |  |  | weight | 1 | 175.4375KB | 17544
GoogLeNet | inception 4d 3x3 red | conv | 512 | 14 | 14 | 144 | 1 | 1 | TRUE | 1 | 1 | 14 | 14 | FALSE |  |  |  |  | 14 | 14 | 14450688 | 98KB | 14KB | 27.5625KB | 72KB | 16KB | FALSE | 25 | 6.545454545KB | 655 | 98KB | 3920 | 27.5625KB | 1103 |  |  |  | weight | 1 | 197.5625KB | 19757
GoogLeNet | inception 4d 5x5 red | conv | 512 | 14 | 14 | 32 | 1 | 1 | TRUE | 1 | 1 | 14 | 14 | FALSE |  |  |  |  | 14 | 14 | 3211264 | 98KB | 14KB | 6.125KB | 16KB | 16KB | FALSE | 25 | 1.454545455KB | 146 | 98KB | 3920 | 6.125KB | 245 |  |  |  | weight | 1 | 120.125KB | 12013
GoogLeNet | Inception 4d 1x1 (combined) | conv | 512 | 14 | 14 | 288 | 1 | 1 | TRUE | 1 | 1 | 14 | 14 | FALSE |  |  |  |  | 14 | 14 |  | 98KB | 14KB | 55.125KB | 144KB | 16KB | FALSE | 25 | 13.09090909KB | 1310 | 98KB | 3920 | 55.125KB | 2205 | 14112 | 14112 | MAC | weight | 1 | 297.125KB | 29713 | 14112 | 29713 | DRAM
GoogLeNet | inception 4d 3x3 | conv | 144 | 14 | 14 | 288 | 3 | 3 | TRUE | 1 | 1 | 14 | 14 | FALSE |  |  |  |  | 14 | 14 | 73156608 | 27.5625KB | 7.875KB | 55.125KB | 364.5KB | 40.5KB | TRUE | 25 | 33.13636364KB | 3314 | 392.0625KB | 15683 | 55.125KB | 2205 | 15876 | 15876 | MAC | feature | 1 | 447.1875KB | 44719 | 15876 | 44719 | DRAM
GoogLeNet | inception 4d 5x5 | conv | 32 | 14 | 14 | 64 | 5 | 5 | TRUE | 1 | 1 | 14 | 14 | FALSE |  |  |  |  | 14 | 14 | 10035200 | 6.125KB | 2.625KB | 12.25KB | 50KB | 25KB | FALSE | 25 | 4.545454545KB | 455 | 56.125KB | 2245 | 12.25KB | 490 | 4900 | 4900 | MAC | feature | 1 | 68.375KB | 6838 | 4900 | 6838 | DRAM
GoogLeNet | inception 4d pool proj | conv | 512 | 14 | 14 | 64 | 1 | 1 | TRUE | 1 | 1 | 14 | 14 | FALSE |  |  |  |  | 14 | 14 | 6422528 | 98KB | 14KB | 12.25KB | 32KB | 16KB | FALSE | 25 | 2.909090909KB | 291 | 130KB | 5200 | 12.25KB | 490 | 3136 | 5200 | CVSRAM-R | weight | 1 | 142.25KB | 14225 | 3136 | 14225 | DRAM
 |  |  |  |  |  |  |  |  |  |  |  |  |  |  |  |  |  |  |  |  |  |  |  |  |  |  |  |  | 252.7443182KB | 25275 |  |  |  |  |  | 0 | NONE |  | 1
GoogLeNet | inception 4e 1x1 | conv | 528 | 14 | 14 | 256 | 1 | 1 | TRUE | 1 | 1 | 14 | 14 | FALSE |  |  |  |  | 14 | 14 | 26492928 | 101.0625KB | 14.4375KB | 49KB | 132KB | 16.5KB | FALSE | 21 | 12KB | 1200 | 101.0625KB | 4043 | 49KB | 1960 |  |  |  | weight | 1 | 282.0625KB | 28207
GoogLeNet | inception 4e 3x3 red | conv | 528 | 14 | 14 | 160 | 1 | 1 | TRUE | 1 | 1 | 14 | 14 | FALSE |  |  |  |  | 14 | 14 | 16558080 | 101.0625KB | 14.4375KB | 30.625KB | 82.5KB | 16.5KB | FALSE | 21 | 7.5KB | 750 | 101.0625KB | 4043 | 30.625KB | 1225 |  |  |  | weight | 1 | 214.1875KB | 21419
GoogLeNet | inception 4e 5x5 red | conv | 528 | 14 | 14 | 32 | 1 | 1 | TRUE | 1 | 1 | 14 | 14 | FALSE |  |  |  |  | 14 | 14 | 3311616 | 101.0625KB | 14.4375KB | 6.125KB | 16.5KB | 16.5KB | FALSE | 21 | 1.5KB | 150 | 101.0625KB | 4043 | 6.125KB | 245 |  |  |  | weight | 1 | 123.6875KB | 12369
GoogLeNet | Inception 4e 1x1 (combined) | conv | 528 | 14 | 14 | 448 | 1 | 1 | TRUE | 1 | 1 | 14 | 14 | FALSE |  |  |  |  | 14 | 14 |  | 101.0625KB | 14.4375KB | 85.75KB | 231KB | 16.5KB | FALSE | 21 | 21KB | 2100 | 101.0625KB | 4043 | 85.75KB | 3430 | 22638 | 22638 | MAC | weight | 1 | 417.8125KB | 41782 | 22638 | 41782 | DRAM
GoogLeNet | inception 4e 3x3 | conv | 160 | 14 | 14 | 320 | 3 | 3 | TRUE | 1 | 1 | 14 | 14 | FALSE |  |  |  |  | 14 | 14 | 90316800 | 30.625KB | 8.75KB | 61.25KB | 450KB | 45KB | TRUE | 21 | 40.90909091KB | 4091 | 480.625KB | 19225 | 61.25KB | 2450 | 19600 | 19600 | MAC | feature | 1 | 541.875KB | 54188 | 19600 | 54188 | DRAM
GoogLeNet | inception 4e 5x5 | conv | 32 | 14 | 14 | 128 | 5 | 5 | TRUE | 1 | 1 | 14 | 14 | FALSE |  |  |  |  | 14 | 14 | 20070400 | 6.125KB | 2.625KB | 24.5KB | 100KB | 25KB | FALSE | 21 | 9.090909091KB | 910 | 106.125KB | 4245 | 24.5KB | 980 | 9800 | 9800 | MAC | feature | 1 | 130.625KB | 13063 | 9800 | 13063 | DRAM
GoogLeNet | inception 4e pool proj | conv | 528 | 14 | 14 | 128 | 1 | 1 | TRUE | 1 | 1 | 14 | 14 | TRUE | 3 | 3 | 2 | 2 | 7 | 7 | 13246464 | 101.0625KB | 14.4375KB | 6.125KB | 66KB | 16.5KB | FALSE | 21 | 6KB | 600 | 167.0625KB | 6683 | 6.125KB | 245 | 6468 | 6683 | CVSRAM-R | weight | 1 | 173.1875KB | 17319 | 6468 | 17319 | DRAM
 |  |  |  |  |  |  |  |  |  |  |  |  |  |  |  |  |  |  |  |  |  |  |  |  |  |  |  |  | 318.9375KB | 31894 |  |  |  |  |  | 0 | NONE |  | 1
GoogLeNet | inception 5a 1x1 | conv | 832 | 7 | 7 | 256 | 1 | 1 | TRUE | 1 | 1 | 7 | 7 | FALSE |  |  |  |  | 7 | 7 | 10436608 | 39.8125KB | 11.375KB | 12.25KB | 208KB | 26KB | FALSE | 55 | 58.72159091KB | 5873 | 43.59431818KB | 1744 | 12.25KB | 490 |  |  |  | weight | 1 | 260.0625KB | 26007
GoogLeNet | inception 5a 3x3 red | conv | 832 | 7 | 7 | 160 | 1 | 1 | TRUE | 1 | 1 | 7 | 7 | FALSE |  |  |  |  | 7 | 7 | 6522880 | 39.8125KB | 11.375KB | 7.65625KB | 130KB | 26KB | FALSE | 55 | 11.81818182KB | 1182 | 42.17613636KB | 1688 | 7.65625KB | 307 |  |  |  | weight | 1 | 177.46875KB | 17747
GoogLeNet | inception 5a 5x5 red | conv | 832 | 7 | 7 | 32 | 1 | 1 | TRUE | 1 | 1 | 7 | 7 | FALSE |  |  |  |  | 7 | 7 | 1304576 | 39.8125KB | 11.375KB | 1.53125KB | 26KB | 26KB | FALSE | 55 | 2.363636364KB | 237 | 40.28522727KB | 1612 | 1.53125KB | 62 |  |  |  | weight | 1 | 67.34375KB | 6735
GoogLeNet | Inception 5a 1x1 (combined) | conv | 832 | 7 | 7 | 448 | 1 | 1 | TRUE | 1 | 1 | 7 | 7 | FALSE |  |  |  |  | 7 | 7 |  | 39.8125KB | 11.375KB | 21.4375KB | 364KB | 26KB | FALSE | 55 | 221.8125KB | 22182 | 39.8125KB | 1593 | 21.4375KB | 858 | 8918 | 22182 | DRAM | weight | 1 | 425.25KB | 42525 | 8918 | 42525 | DRAM
GoogLeNet | inception 5a 3x3 | conv | 160 | 7 | 7 | 320 | 3 | 3 | TRUE | 1 | 1 | 7 | 7 | FALSE |  |  |  |  | 7 | 7 | 22579200 | 7.65625KB | 4.375KB | 15.3125KB | 450KB | 45KB | TRUE | 55 | 56.22159091KB | 5623 | 15.83806818KB | 634 | 0KB | 0 | 4900 | 5623 | DRAM | feature | 1 | 472.96875KB | 47297 | 4900 | 47297 | DRAM
GoogLeNet | inception 5a 5x5 | conv | 32 | 7 | 7 | 128 | 5 | 5 | TRUE | 1 | 1 | 7 | 7 | FALSE |  |  |  |  | 7 | 7 | 5017600 | 1.53125KB | 1.3125KB | 6.125KB | 100KB | 25KB | FALSE | 55 | 15.21590909KB | 1522 | 3.349431818KB | 134 | 0KB | 0 | 2450 | 2450 | MAC | feature | 1 | 107.65625KB | 10766 | 2450 | 10766 | DRAM
GoogLeNet | inception 5a pool proj | conv | 832 | 7 | 7 | 128 | 1 | 1 | TRUE | 1 | 1 | 7 | 7 | FALSE |  |  |  |  | 7 | 7 | 5218304 | 39.8125KB | 11.375KB | 6.125KB | 104KB | 26KB | FALSE | 55 | 15.57954545KB | 1558 | 41.70340909KB | 1669 | 0KB | 0 | 2548 | 2548 | MAC | weight | 1 | 149.9375KB | 14994 | 2548 | 14994 | DRAM
GoogLeNet | inception 5b 1x1 | conv | 832 | 7 | 7 | 384 | 1 | 1 | TRUE | 1 | 1 | 7 | 7 | FALSE |  |  |  |  | 7 | 7 | 15654912 | 39.8125KB | 11.375KB | 18.375KB | 312KB | 26KB | FALSE | 42 | 68.17613636KB | 6818 | 47.24107143KB | 1890 | 18.375KB | 735 |  |  |  | weight | 1 | 370.1875KB | 37019
GoogLeNet | inception 5b 3x3 red | conv | 832 | 7 | 7 | 192 | 1 | 1 | TRUE | 1 | 1 | 7 | 7 | FALSE |  |  |  |  | 7 | 7 | 7827456 | 39.8125KB | 11.375KB | 9.1875KB | 156KB | 26KB | FALSE | 42 | 14.18181818KB | 1419 | 43.52678571KB | 1742 | 9.1875KB | 368 |  |  |  | weight | 1 | 205KB | 20500
GoogLeNet | inception 5b 5x5 red | conv | 832 | 7 | 7 | 48 | 1 | 1 | TRUE | 1 | 1 | 7 | 7 | FALSE |  |  |  |  | 7 | 7 | 1956864 | 39.8125KB | 11.375KB | 2.296875KB | 39KB | 26KB | FALSE | 42 | 3.545454545KB | 355 | 40.74107143KB | 1630 | 2.296875KB | 92 |  |  |  | weight | 1 | 81.109375KB | 8111
GoogLeNet | Inception 5b 1x1 (combined) | conv | 832 | 7 | 7 | 624 | 1 | 1 | TRUE | 1 | 1 | 7 | 7 | FALSE |  |  |  |  | 7 | 7 |  | 39.8125KB | 11.375KB | 29.859375KB | 507KB | 26KB | FALSE | 42 | 293.3125KB | 29332 | 39.8125KB | 1593 | 29.859375KB | 1195 | 12421.5 | 29332 | DRAM | weight | 2 | 616.484375KB | 61649 | 12421.5 | 61649 | DRAM
GoogLeNet | inception 5b 3x3 | conv | 192 | 7 | 7 | 384 | 3 | 3 | TRUE | 1 | 1 | 7 | 7 | FALSE |  |  |  |  | 7 | 7 | 32514048 | 9.1875KB | 5.25KB | 18.375KB | 648KB | 54KB | TRUE | 42 | 77.28409091KB | 7729 | 24.61607143KB | 985 | 0KB | 0 | 7056 | 7729 | DRAM | feature | 1 | 675.5625KB | 67557 | 7056 | 67557 | DRAM
GoogLeNet | inception 5b 5x5 | conv | 48 | 7 | 7 | 128 | 5 | 5 | TRUE | 1 | 1 | 7 | 7 | FALSE |  |  |  |  | 7 | 7 | 7526400 | 2.296875KB | 1.96875KB | 6.125KB | 150KB | 37.5KB | FALSE | 42 | 19.76136364KB | 1977 | 5.868303571KB | 235 | 0KB | 0 | 3675 | 3675 | MAC | feature | 1 | 158.421875KB | 15843 | 3675 | 15843 | DRAM
GoogLeNet | inception 5b pool proj | conv | 832 | 7 | 7 | 128 | 1 | 1 | TRUE | 1 | 1 | 7 | 7 | TRUE | 7 | 7 | 1 | 1 | 1 | 1 | 5218304 | 39.8125KB | 11.375KB | 0.125KB | 104KB | 26KB | FALSE | 42 | 9.579545455KB | 958 | 42.28869048KB | 1692 | 0KB | 0 | 2548 | 2548 | MAC | weight | 1 | 143.9375KB | 14394 | 2548 | 14394 | DRAM
GoogLeNet | fc | fc | 1024 | 1 | 1 | 1000 | 1 | 1 | FALSE | 1 | 1 | 1 | 1 | FALSE |  |  |  |  | 1 | 1 | 1024000 | 1KB | 1KB | 0.984375KB | 1000KB | 32KB | FALSE | 16 | 63.5KB | 6350 | 0KB | 0 | 0KB | 0 | 500 | 6350 | DRAM | feature | 1 | 1001.984375KB | 100199 | 500 | 100199 | DRAM
GoogLeNet | total |  |  |  |  |  |  |  |  |  |  |  |  |  |  |  |  |  |  |  |  |  |  |  |  |  |  |  |  |  |  |  |  |  |  | 579712.5 | Cycles |  |  |  |  |  | 1222071 | cycle
GoogLeNet | total |  |  |  |  |  |  |  |  |  |  |  |  |  |  |  |  |  |  |  |  |  |  |  |  |  |  |  |  |  |  |  |  |  |  | 0.5797125 | ms |  |  |  |  |  | 1.222071 | ms
GoogLeNet | total |  |  |  |  |  |  |  |  |  |  |  |  |  |  |  |  |  |  |  |  |  |  |  |  |  |  |  |  |  |  |  |  |  |  | 1724.992992 | FPS |  |  |  |  |  | 818.2830621 | FPS
 |  |  |  |  |  |  |  |  |  |  |  |  |  |  |  |  |  |  |  |  |  |  |  |  |  |  |  |  |  |  |  |  |  |  |  |  |  |  |  |  |  |  | HW MAC Effi | 43.19%
 |  |  |  |  |  |  |  |  |  |  |  |  |  |  |  |  |  |  |  |  |  |  |  |  |  |  |  |  |  |  |  |  |  |  |  |  |  |  |  |  |  |  | Network MAC Effi | 62.72%

Sheet: ResNet50
 | Input Data type (Byte) | 1
 | Weight Data Type (Byte) | 1 |  | Compression rate | 0.00%
 | Convolution input buffer (KB) | 512
 | Number of Multiplier(16bit) | 2048
 | Frequency | 1000MHz
 | CVSRAM read BW limitation | 25GBps
 | CVSRAM write BW Limitation | 25GBps
 | DRAM BW Limitation | 10GBps
 | FC batch size | 16
 | Net | Layer | Layer attribute | #input feature maps C | Input Height H | Input Width W | #output feature maps K | Filter Height R | Filter Width S | Zero Padding Z | Vertical Conv Srtide H | Horizontal Conv Stride V | Height after Conv P | Width after Conv Q | Pooling after Conv | Pooling Height D | Pooling Width E | Vertical pooling stride F | Horizontal pooling stride G | Height after Pooling A | Height after Pooling B | Calculation | Input data size | Min input data size | Output data size | Min weight data size | Weight data size | Winograd | Smaller sized | DRAM Traffic | DRAM Traffic | DRAM Cycles | MAC Cycles | MAX Cycle | Long Pole
v | ResNet50 | Conv1 + bn + scale + Relu + Pooling | conv | 3 | 224 | 224 | 64 | 7 | 7 | TRUE | 2 | 2 | 112 | 112 | TRUE | 3 | 3 | 2 | 2 | 56 | 56 | 118013952 | 196KB | 14KB | 196KB | 8KB | 16KB | FALSE | weight | 408KB | 408KB | 40800 | 153664 | 153664 | MAC
v | ResNet50 | Res2a_branch1 + bn + scale | conv | 64 | 56 | 56 | 256 | 1 | 1 | FALSE | 1 | 1 | 56 | 56 | FALSE |  |  |  |  | 56 | 56 | 51380224 | 196KB | 3.5KB | 784KB | 2KB | 16KB | FALSE | weight | 996KB | 996KB | 99600 | 25088 | 99600 | DRAM
v | ResNet50 | Res2a_branch2a + bn + scale + relu | conv | 256 | 56 | 56 | 64 | 1 | 1 | FALSE | 1 | 1 | 56 | 56 | FALSE |  |  |  |  | 56 | 56 | 51380224 | 784KB | 14KB | 196KB | 8KB | 16KB | FALSE | weight | 996KB | 996KB | 99600 | 50176 | 99600 | DRAM
v | ResNet50 | Res2a_branch2b + bn + scale + relu | conv | 64 | 56 | 56 | 64 | 3 | 3 | TRUE | 1 | 1 | 56 | 56 | FALSE |  |  |  |  | 56 | 56 | 115605504 | 196KB | 10.5KB | 196KB | 18KB | 64KB | TRUE | weight | 456KB | 456KB | 45600 | 50176 | 50176 | MAC
v | ResNet50 | Res2a_branch2c + bn + scale + Elwise + relu | conv + elwise | 64 | 56 | 56 | 256 | 1 | 1 | TRUE | 1 | 1 | 56 | 56 | FALSE |  |  |  |  | 56 | 56 | 51380224 | 196KB | 3.5KB | 784KB | 2KB | 16KB | FALSE | weight | 1780KB | 1780KB | 178000 | 25088 | 178000 | DRAM
V | ResNet50 | Res2b_branch2a + bn + scale + relu | conv | 256 | 56 | 56 | 64 | 1 | 1 | TRUE | 1 | 1 | 56 | 56 | FALSE |  |  |  |  | 56 | 56 | 51380224 | 784KB | 14KB | 196KB | 8KB | 16KB | FALSE | weight | 996KB | 996KB | 99600 | 50176 | 99600 | DRAM
V | ResNet50 | Res2b_branch2b + bn + scale + relu | conv | 64 | 56 | 56 | 64 | 3 | 3 | TRUE | 1 | 1 | 56 | 56 | FALSE |  |  |  |  | 56 | 56 | 115605504 | 196KB | 10.5KB | 196KB | 18KB | 64KB | TRUE | weight | 456KB | 456KB | 45600 | 50176 | 50176 | MAC
v | ResNet50 | Res2b_branch2c + bn + scale + Elwise + relu | conv + elwise | 64 | 56 | 56 | 256 | 1 | 1 | TRUE | 1 | 1 | 56 | 56 | FALSE |  |  |  |  | 56 | 56 | 51380224 | 196KB | 3.5KB | 784KB | 2KB | 16KB | FALSE | weight | 1780KB | 1780KB | 178000 | 25088 | 178000 | DRAM
v | ResNet50 | Res2c_branch2a + bn + scale + relu | conv | 256 | 56 | 56 | 64 | 1 | 1 | TRUE | 1 | 1 | 56 | 56 | FALSE |  |  |  |  | 56 | 56 | 51380224 | 784KB | 14KB | 196KB | 8KB | 16KB | FALSE | weight | 996KB | 996KB | 99600 | 50176 | 99600 | DRAM
v | ResNet50 | Res2c_branch2b + bn + scale + relu | conv | 64 | 56 | 56 | 64 | 3 | 3 | TRUE | 1 | 1 | 56 | 56 | FALSE |  |  |  |  | 56 | 56 | 115605504 | 196KB | 10.5KB | 196KB | 18KB | 64KB | TRUE | weight | 456KB | 456KB | 45600 | 50176 | 50176 | MAC
v | ResNet50 | Res2c_branch2c + bn + scale + Elwise + relu | conv + elwise | 64 | 56 | 56 | 256 | 1 | 1 | TRUE | 1 | 1 | 56 | 56 | FALSE |  |  |  |  | 56 | 56 | 51380224 | 196KB | 3.5KB | 784KB | 2KB | 16KB | FALSE | weight | 1780KB | 1780KB | 178000 | 25088 | 178000 | DRAM
v | ResNet50 | Res3a_branch1 + bn + scale | conv | 256 | 56 | 56 | 512 | 1 | 1 | TRUE | 2 | 2 | 28 | 28 | FALSE |  |  |  |  | 28 | 28 | 102760448 | 784KB | 28KB | 392KB | 32KB | 512KB | FALSE | weight | 2472KB | 1688KB | 247200 | 50176 | 247200 | DRAM
v | ResNet50 | Res3a_branch2a + bn + scale + relu | conv | 256 | 56 | 56 | 128 | 1 | 1 | TRUE | 2 | 2 | 28 | 28 | FALSE |  |  |  |  | 28 | 28 | 25690112 | 784KB | 28KB | 98KB | 32KB | 128KB | FALSE | weight | 1010KB | 1010KB | 101000 | 12544 | 101000 | DRAM
v | ResNet50 | Res3a_branch2b + bn + scale + relu | conv | 128 | 28 | 28 | 128 | 3 | 3 | TRUE | 1 | 1 | 28 | 28 | FALSE |  |  |  |  | 28 | 28 | 115605504 | 98KB | 10.5KB | 98KB | 36KB | 256KB | TRUE | feature | 452KB | 452KB | 45200 | 25088 | 45200 | DRAM
v | ResNet50 | Res3a_branch2c + bn + scale + Elwise + relu | conv + elwise | 128 | 28 | 28 | 512 | 1 | 1 | TRUE | 1 | 1 | 28 | 28 | FALSE |  |  |  |  | 28 | 28 | 51380224 | 98KB | 3.5KB | 392KB | 4KB | 64KB | FALSE | weight | 946KB | 946KB | 94600 | 25088 | 94600 | DRAM
v | ResNet50 | Res3b_branch2a + bn + scale + relu | conv | 512 | 28 | 28 | 128 | 1 | 1 | TRUE | 1 | 1 | 28 | 28 | FALSE |  |  |  |  | 28 | 28 | 51380224 | 392KB | 14KB | 98KB | 16KB | 64KB | FALSE | weight | 554KB | 554KB | 55400 | 25088 | 55400 | DRAM
v | ResNet50 | Res3b_branch2b + bn + scale + relu | conv | 128 | 28 | 28 | 128 | 3 | 3 | TRUE | 1 | 1 | 28 | 28 | FALSE |  |  |  |  | 28 | 28 | 115605504 | 98KB | 10.5KB | 98KB | 36KB | 256KB | TRUE | feature | 452KB | 452KB | 45200 | 25088 | 45200 | DRAM
v | ResNet50 | Res3b_branch2c + bn + scale + Elwise + relu | conv + elwise | 128 | 28 | 28 | 512 | 1 | 1 | TRUE | 1 | 1 | 28 | 28 | FALSE |  |  |  |  | 28 | 28 | 51380224 | 98KB | 3.5KB | 392KB | 4KB | 64KB | FALSE | weight | 946KB | 946KB | 94600 | 25088 | 94600 | DRAM
v | ResNet50 | Res3c_branch2a + bn + scale + relu | conv | 512 | 28 | 28 | 128 | 1 | 1 | TRUE | 1 | 1 | 28 | 28 | FALSE |  |  |  |  | 28 | 28 | 51380224 | 392KB | 14KB | 98KB | 16KB | 64KB | FALSE | weight | 554KB | 554KB | 55400 | 25088 | 55400 | DRAM
v | ResNet50 | Res3c_branch2b + bn + scle + relu | conv | 128 | 28 | 28 | 128 | 3 | 3 | TRUE | 1 | 1 | 28 | 28 | FALSE |  |  |  |  | 28 | 28 | 115605504 | 98KB | 10.5KB | 98KB | 36KB | 256KB | TRUE | feature | 452KB | 452KB | 45200 | 25088 | 45200 | DRAM
v | ResNet50 | Res3c_branch2c + bn + scale + Elwise + relu | conv + elwise | 128 | 28 | 28 | 512 | 1 | 1 | TRUE | 1 | 1 | 28 | 28 | FALSE |  |  |  |  | 28 | 28 | 51380224 | 98KB | 3.5KB | 392KB | 4KB | 64KB | FALSE | weight | 946KB | 946KB | 94600 | 25088 | 94600 | DRAM
v | ResNet50 | Res3d_branch2a + bn + scale + relu | conv | 512 | 28 | 28 | 128 | 1 | 1 | TRUE | 1 | 1 | 28 | 28 | FALSE |  |  |  |  | 28 | 28 | 51380224 | 392KB | 14KB | 98KB | 16KB | 64KB | FALSE | weight | 554KB | 554KB | 55400 | 25088 | 55400 | DRAM
v | ResNet50 | Res3d_branch2b + bn + scale + relu | conv | 128 | 28 | 28 | 128 | 3 | 3 | TRUE | 1 | 1 | 28 | 28 | FALSE |  |  |  |  | 28 | 28 | 115605504 | 98KB | 10.5KB | 98KB | 36KB | 256KB | TRUE | feature | 452KB | 452KB | 45200 | 25088 | 45200 | DRAM
v | ResNet50 | Res3d_branch2c + bn + scale + Elwise + relu | conv + elwise | 128 | 28 | 28 | 512 | 1 | 1 | TRUE | 1 | 1 | 28 | 28 | FALSE |  |  |  |  | 28 | 28 | 51380224 | 98KB | 3.5KB | 392KB | 4KB | 64KB | FALSE | weight | 946KB | 946KB | 94600 | 25088 | 94600 | DRAM
v | ResNet50 | Res4a_branch1 + bn + scale | conv | 512 | 28 | 28 | 1024 | 1 | 1 | TRUE | 2 | 2 | 14 | 14 | FALSE |  |  |  |  | 14 | 14 | 102760448 | 392KB | 28KB | 196KB | 64KB | 2048KB | FALSE | feature | 2636KB | 2636KB | 263600 | 50176 | 263600 | DRAM
v | ResNet50 | Res4a_branch2a + bn + scale + relu | conv | 512 | 28 | 28 | 256 | 1 | 1 | TRUE | 2 | 2 | 14 | 14 | FALSE |  |  |  |  | 14 | 14 | 25690112 | 392KB | 28KB | 49KB | 64KB | 512KB | FALSE | feature | 953KB | 953KB | 95300 | 12544 | 95300 | DRAM
v | ResNet50 | Res4a_branch2b + bn + scale + relu | conv | 256 | 14 | 14 | 256 | 3 | 3 | TRUE | 1 | 1 | 14 | 14 | FALSE |  |  |  |  | 14 | 14 | 115605504 | 49KB | 10.5KB | 49KB | 72KB | 1024KB | TRUE | feature | 1122KB | 1122KB | 112200 | 25088 | 112200 | DRAM
v | ResNet50 | Res4a_branch2c + bn + scale + Elwise + relu | conv + elwise | 256 | 14 | 14 | 1024 | 1 | 1 | TRUE | 1 | 1 | 14 | 14 | FALSE |  |  |  |  | 14 | 14 | 51380224 | 49KB | 3.5KB | 196KB | 8KB | 256KB | FALSE | feature | 697KB | 697KB | 69700 | 25088 | 69700 | DRAM
v | ResNet50 | Res4b_branch2a + bn + scale + relu | conv | 1024 | 14 | 14 | 256 | 1 | 1 | TRUE | 1 | 1 | 14 | 14 | FALSE |  |  |  |  | 14 | 14 | 51380224 | 196KB | 14KB | 49KB | 32KB | 256KB | FALSE | feature | 501KB | 501KB | 50100 | 25088 | 50100 | DRAM
v | ResNet50 | Res4b_branch2b + bn + scale + relu | conv | 256 | 14 | 14 | 256 | 3 | 3 | TRUE | 1 | 1 | 14 | 14 | FALSE |  |  |  |  | 14 | 14 | 115605504 | 49KB | 10.5KB | 49KB | 72KB | 1024KB | TRUE | feature | 1122KB | 1122KB | 112200 | 25088 | 112200 | DRAM
v | ResNet50 | Res4b_branch2c + bn + scale + Elwise + relu | conv + elwise | 256 | 14 | 14 | 1024 | 1 | 1 | TRUE | 1 | 1 | 14 | 14 | FALSE |  |  |  |  | 14 | 14 | 51380224 | 49KB | 3.5KB | 196KB | 8KB | 256KB | FALSE | feature | 697KB | 697KB | 69700 | 25088 | 69700 | DRAM
v | ResNet50 | Res4c_branch2a + bn + scale + relu | conv | 1024 | 14 | 14 | 256 | 1 | 1 | TRUE | 1 | 1 | 14 | 14 | FALSE |  |  |  |  | 14 | 14 | 51380224 | 196KB | 14KB | 49KB | 32KB | 256KB | FALSE | feature | 501KB | 501KB | 50100 | 25088 | 50100 | DRAM
v | ResNet50 | Res4c_branch2b + bn + scale + relu | conv | 256 | 14 | 14 | 256 | 3 | 3 | TRUE | 1 | 1 | 14 | 14 | FALSE |  |  |  |  | 14 | 14 | 115605504 | 49KB | 10.5KB | 49KB | 72KB | 1024KB | TRUE | feature | 1122KB | 1122KB | 112200 | 25088 | 112200 | DRAM
v | ResNet50 | Res4c_branch2c + bn + scale + Elwise + relu | conv + elwise | 256 | 14 | 14 | 1024 | 1 | 1 | TRUE | 1 | 1 | 14 | 14 | FALSE |  |  |  |  | 14 | 14 | 51380224 | 49KB | 3.5KB | 196KB | 8KB | 256KB | FALSE | feature | 697KB | 697KB | 69700 | 25088 | 69700 | DRAM
v | ResNet50 | Res4d_branch2a + bn + scale + relu | conv | 1024 | 14 | 14 | 256 | 1 | 1 | TRUE | 1 | 1 | 14 | 14 | FALSE |  |  |  |  | 14 | 14 | 51380224 | 196KB | 14KB | 49KB | 32KB | 256KB | FALSE | feature | 501KB | 501KB | 50100 | 25088 | 50100 | DRAM
v | ResNet50 | Res4d_branch2b + bn + scale + relu | conv | 256 | 14 | 14 | 256 | 3 | 3 | TRUE | 1 | 1 | 14 | 14 | FALSE |  |  |  |  | 14 | 14 | 115605504 | 49KB | 10.5KB | 49KB | 72KB | 1024KB | TRUE | feature | 1122KB | 1122KB | 112200 | 25088 | 112200 | DRAM
v | ResNet50 | Res4d_branch2c + bn + scale + Elwise + relu | conv + elwise | 256 | 14 | 14 | 1024 | 1 | 1 | TRUE | 1 | 1 | 14 | 14 | FALSE |  |  |  |  | 14 | 14 | 51380224 | 49KB | 3.5KB | 196KB | 8KB | 256KB | FALSE | feature | 697KB | 697KB | 69700 | 25088 | 69700 | DRAM
v | ResNet50 | Res4e_branch2a + bn + scale + relu | conv | 1024 | 14 | 14 | 256 | 1 | 1 | TRUE | 1 | 1 | 14 | 14 | FALSE |  |  |  |  | 14 | 14 | 51380224 | 196KB | 14KB | 49KB | 32KB | 256KB | FALSE | feature | 501KB | 501KB | 50100 | 25088 | 50100 | DRAM
v | ResNet50 | Res4e_branch2b + bn + scale + relu | conv | 256 | 14 | 14 | 256 | 3 | 3 | TRUE | 1 | 1 | 14 | 14 | FALSE |  |  |  |  | 14 | 14 | 115605504 | 49KB | 10.5KB | 49KB | 72KB | 1024KB | TRUE | feature | 1122KB | 1122KB | 112200 | 25088 | 112200 | DRAM
v | ResNet50 | Res4e_branch2c + bn + scale + Elwise + relu | conv + elwise | 256 | 14 | 14 | 1024 | 1 | 1 | TRUE | 1 | 1 | 14 | 14 | FALSE |  |  |  |  | 14 | 14 | 51380224 | 49KB | 3.5KB | 196KB | 8KB | 256KB | FALSE | feature | 697KB | 697KB | 69700 | 25088 | 69700 | DRAM
v | ResNet50 | Res4f_branch2a + bn + scale + relu | conv | 1024 | 14 | 14 | 256 | 1 | 1 | TRUE | 1 | 1 | 14 | 14 | FALSE |  |  |  |  | 14 | 14 | 51380224 | 196KB | 14KB | 49KB | 32KB | 256KB | FALSE | feature | 501KB | 501KB | 50100 | 25088 | 50100 | DRAM
v | ResNet50 | Res4f_branch2b + bn + scale + relu | conv | 256 | 14 | 14 | 256 | 3 | 3 | TRUE | 1 | 1 | 14 | 14 | FALSE |  |  |  |  | 14 | 14 | 115605504 | 49KB | 10.5KB | 49KB | 72KB | 1024KB | TRUE | feature | 1122KB | 1122KB | 112200 | 25088 | 112200 | DRAM
v | ResNet50 | Res4f_branch2c + bn + scale + Elwise + relu | conv + elwise | 256 | 14 | 14 | 1024 | 1 | 1 | TRUE | 1 | 1 | 14 | 14 | FALSE |  |  |  |  | 14 | 14 | 51380224 | 49KB | 3.5KB | 196KB | 8KB | 256KB | FALSE | feature | 697KB | 697KB | 69700 | 25088 | 69700 | DRAM
v | ResNet50 | Res5a_branch1 + bn + scale | conv | 1024 | 14 | 14 | 2048 | 1 | 1 | TRUE | 2 | 2 | 7 | 7 | FALSE |  |  |  |  | 7 | 7 | 102760448 | 196KB | 28KB | 98KB | 128KB | 8192KB | FALSE | feature | 8486KB | 8486KB | 848600 | 50176 | 848600 | DRAM
v | ResNet50 | Res5a_branch2a + bn + scale + relu | conv | 1024 | 14 | 14 | 512 | 1 | 1 | TRUE | 2 | 2 | 7 | 7 | FALSE |  |  |  |  | 7 | 7 | 25690112 | 196KB | 28KB | 24.5KB | 128KB | 2048KB | FALSE | feature | 2268.5KB | 2268.5KB | 226850 | 12544 | 226850 | DRAM
v | ResNet50 | Res5a_branch2b + bn + scale + relu | conv | 512 | 7 | 7 | 512 | 3 | 3 | TRUE | 1 | 1 | 7 | 7 | FALSE |  |  |  |  | 7 | 7 | 115605504 | 24.5KB | 10.5KB | 24.5KB | 144KB | 4096KB | TRUE | feature | 4145KB | 4145KB | 414500 | 25088 | 414500 | DRAM
v | ResNet50 | Res5a_branch2c + bn + scale + Elwise + relu | conv + elwise | 512 | 7 | 7 | 2048 | 1 | 1 | TRUE | 1 | 1 | 7 | 7 | FALSE |  |  |  |  | 7 | 7 | 51380224 | 24.5KB | 3.5KB | 98KB | 16KB | 1024KB | FALSE | feature | 1244.5KB | 1244.5KB | 124450 | 25088 | 124450 | DRAM
v | ResNet50 | Res5b_branch2a + bn + scale + relu | conv | 2048 | 7 | 7 | 512 | 1 | 1 | TRUE | 1 | 1 | 7 | 7 | FALSE |  |  |  |  | 7 | 7 | 51380224 | 98KB | 14KB | 24.5KB | 64KB | 1024KB | FALSE | feature | 1146.5KB | 1146.5KB | 114650 | 25088 | 114650 | DRAM
v | ResNet50 | Res5b_branch2b + bn + scale + relu | conv | 512 | 7 | 7 | 512 | 3 | 3 | TRUE | 1 | 1 | 7 | 7 | FALSE |  |  |  |  | 7 | 7 | 115605504 | 24.5KB | 10.5KB | 24.5KB | 144KB | 4096KB | TRUE | feature | 4145KB | 4145KB | 414500 | 25088 | 414500 | DRAM
v | ResNet50 | Res5b_branch2c + bn + scale + Elwise + relu | conv + elwise | 512 | 7 | 7 | 2048 | 1 | 1 | TRUE | 1 | 1 | 7 | 7 | FALSE |  |  |  |  | 7 | 7 | 51380224 | 24.5KB | 3.5KB | 98KB | 16KB | 1024KB | FALSE | feature | 1244.5KB | 1244.5KB | 124450 | 25088 | 124450 | DRAM
 | ResNet50 | Res5c_branch2a + bn + scale + relu | conv | 2048 | 7 | 7 | 512 | 1 | 1 | TRUE | 1 | 1 | 7 | 7 | FALSE |  |  |  |  | 7 | 7 | 51380224 | 98KB | 14KB | 24.5KB | 64KB | 1024KB | FALSE | feature | 1146.5KB | 1146.5KB | 114650 | 25088 | 114650 | DRAM
 | ResNet50 | Res5c_branch2b + bn + scale + relu | conv | 512 | 7 | 7 | 512 | 3 | 3 | TRUE | 1 | 1 | 7 | 7 | FALSE |  |  |  |  | 7 | 7 | 115605504 | 24.5KB | 10.5KB | 24.5KB | 144KB | 4096KB | TRUE | feature | 4145KB | 4145KB | 414500 | 25088 | 414500 | DRAM
 | ResNet50 | Res5c_branch2c + bn + scale + Elwise + relu | conv + elwise | 512 | 7 | 7 | 2048 | 1 | 1 | TRUE | 1 | 1 | 7 | 7 | TRUE | 7 | 7 | 7 | 7 | 1 | 1 | 51380224 | 24.5KB | 3.5KB | 2KB | 16KB | 1024KB | FALSE | feature | 1052.5KB | 1052.5KB | 105250 | 25088 | 105250 | DRAM
 | ResNet50 | fc1000 | fc | 2048 | 1 | 1 | 1000 | 1 | 1 | FALSE | 1 | 1 | 1 | 1 | FALSE |  |  |  |  | 1 | 1 | 2048000 | 2KB | 2KB | 0.984375KB | 64KB | 2000KB | FALSE | feature | 2002.984375KB | 127.984375KB | 200299 | 1000 | 200299 | DRAM
 | ResNet50 |  |  |  |  |  |  |  |  |  |  |  |  |  |  |  |  |  |  |  |  |  |  |  |  |  |  |  |  |  |  |  | Total Cycle | 7113691
 | ResNet50 | total |  |  |  |  |  |  |  |  |  |  |  |  |  |  |  |  |  |  |  |  |  |  |  |  |  |  |  |  |  |  | Total Time | 7.113691MHz | ms
 | ResNet50 |  |  |  |  |  |  |  |  |  |  |  |  |  |  |  |  |  |  |  |  |  |  |  |  |  |  |  |  |  |  |  | FPS | 140.5740002 | FPS
 |  |  |  |  |  |  |  |  |  |  |  |  |  |  |  |  |  |  |  |  |  |  |  |  |  |  |  |  |  |  |  |  | HW MAC Effi | 23.16%
 |  |  |  |  |  |  |  |  |  |  |  |  |  |  |  |  |  |  |  |  |  |  |  |  |  |  |  |  |  |  |  |  | Network MAC Effi | 26.75%
