SUAT-lhy/MEISHA-V100-A-Silicon-Proven-Quad-Core-RISC-V-SoC/trunk/hw/ip/usbdev/pmod/dualpmod-kicad/dualpmod.kicad_pcb

## KiCad design trunk/hw/ip/usbdev/pmod/dualpmod-kicad/dualpmod.kicad_pcb (2026-03-25)

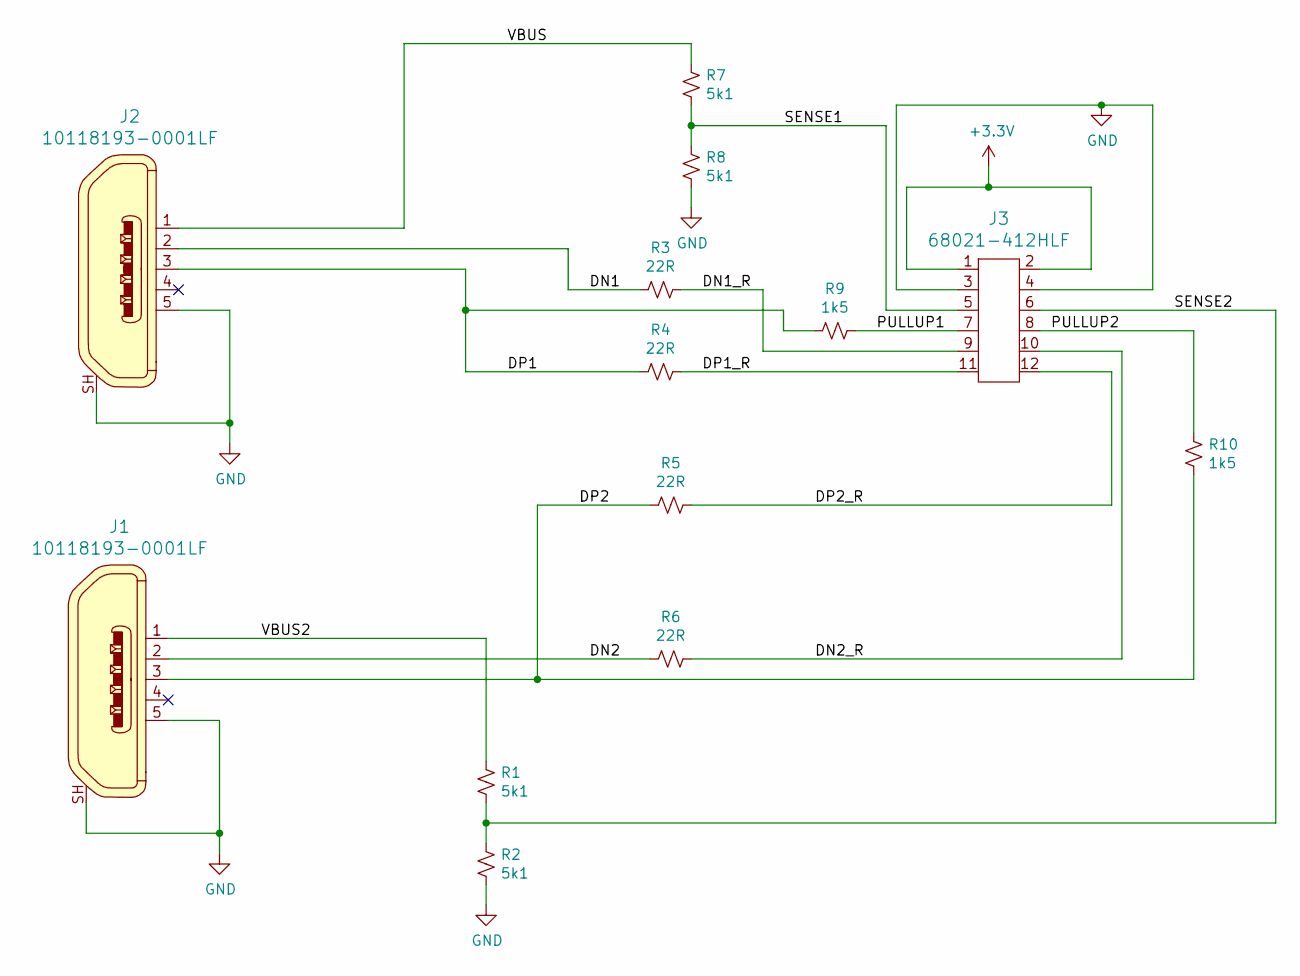
[picture p61: schematic dualpmod.sch]

Parts:
J1, J2: 10118193-0001LF; USB_Micro_B_Female_10118193-0001LF; MPN 10118193-0001LF; Digi-Key_PN 609-4616-1-ND
J3: 68021-412HLF; PinHeader_6x2_P2.54mm_Horizontal; MPN 68021-412HLF; Digi-Key_PN 609-3355-ND
R1, R2, R7, R8: 5k1; R_0805_2012Metric_Pad1.15x1.40mm_HandSolder
R3, R4, R5, R6: 22R; R_0805_2012Metric_Pad1.15x1.40mm_HandSolder
R9, R10: 1k5; R_0805_2012Metric_Pad1.15x1.40mm_HandSolder

Connections:
+3V3: J3.1, J3.2
/DN1: J2.2, R3.2
/DN1_R: J3.9, R3.1
/DN2: J1.2, R6.2
/DN2_R: J3.10, R6.1
/DP1: J2.3, R4.2, R9.2
/DP1_R: J3.11, R4.1
/DP2: J1.3, R5.2, R10.2
/DP2_R: J3.12, R5.1
/PULLUP1: J3.7, R9.1
/PULLUP2: J3.8, R10.1
/SENSE1: J3.5, R7.2, R8.1
/SENSE2: J3.6, R1.2, R2.1
/VBUS: J2.1, R7.1
/VBUS2: J1.1, R1.1
GND: J1.5, J1.SH, J2.5, J2.SH, J3.3, J3.4, R2.2, R8.2

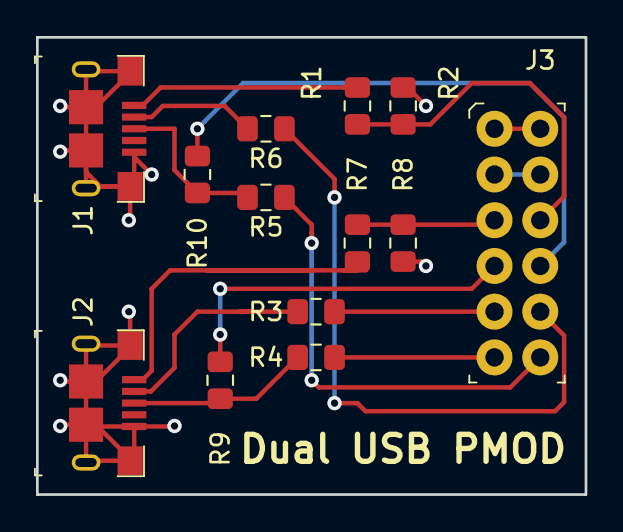
[picture p62: board dualpmod.kicad_pcb from above]

Board: 2 copper layers, 30.5 x 25.4 mm, 13 parts (0 on the bottom side), 16 nets.
