SUAT-lhy/MEISHA-V100-A-Silicon-Proven-Quad-Core-RISC-V-SoC/trunk/hw/d2dv100_top/dv/th/MEISHAV100_TOP_init_bind.sv

`define BIND_MODULE_CLOSE_INIT(name) \
  module init_``name``(); \
    initial begin \
      force ``name``.clock = 0; \
      force ``name``.reset = 1; \
    end \
  endmodule \
  bind ``name`` init_``name`` u_init_``name``();
  


/*
module TLMonitor_22( 
  input         clock, 
  input         reset, 
  input         io_in_a_ready, 
  input         io_in_a_valid, 
  input  [2:0]  io_in_a_bits_opcode, 
  input  [2:0]  io_in_a_bits_param, 
  input  [2:0]  io_in_a_bits_size, 
  input  [1:0]  io_in_a_bits_source, 
  input  [31:0] io_in_a_bits_address, 
  input  [7:0]  io_in_a_bits_mask, 
  input         io_in_a_bits_corrupt, 
  input         io_in_b_ready, 
  input         io_in_b_valid, 
  input  [2:0]  io_in_b_bits_opcode, 
  input  [1:0]  io_in_b_bits_param, 
  input  [2:0]  io_in_b_bits_size, 
  input  [1:0]  io_in_b_bits_source, 
  input  [31:0] io_in_b_bits_address, 
  input  [7:0]  io_in_b_bits_mask, 
  input         io_in_b_bits_corrupt, 
  input         io_in_c_ready, 
  input         io_in_c_valid, 
  input  [2:0]  io_in_c_bits_opcode, 
  input  [2:0]  io_in_c_bits_param, 
  input  [2:0]  io_in_c_bits_size, 
  input  [1:0]  io_in_c_bits_source, 
  input  [31:0] io_in_c_bits_address, 
  input         io_in_c_bits_corrupt, 
  input         io_in_d_ready, 
  input         io_in_d_valid, 
  input  [2:0]  io_in_d_bits_opcode, 
  input  [1:0]  io_in_d_bits_param, 
  input  [2:0]  io_in_d_bits_size, 
  input  [1:0]  io_in_d_bits_source, 
  input  [2:0]  io_in_d_bits_sink, 
  input         io_in_d_bits_denied, 
  input         io_in_d_bits_corrupt, 
  input         io_in_e_ready, 
  input         io_in_e_valid, 
  input  [2:0]  io_in_e_bits_sink 
);

endmodule


module TLMonitor( 
  input         clock, 
  input         reset, 
  input         io_in_a_ready, 
  input         io_in_a_valid, 
  input  [2:0]  io_in_a_bits_opcode, 
  input  [2:0]  io_in_a_bits_param, 
  input  [2:0]  io_in_a_bits_size, 
  input  [1:0]  io_in_a_bits_source, 
  input  [31:0] io_in_a_bits_address, 
  input  [7:0]  io_in_a_bits_mask, 
  input         io_in_a_bits_corrupt, 
  input         io_in_b_ready, 
  input         io_in_b_valid, 
  input  [2:0]  io_in_b_bits_opcode, 
  input  [1:0]  io_in_b_bits_param, 
  input  [2:0]  io_in_b_bits_size, 
  input  [1:0]  io_in_b_bits_source, 
  input  [31:0] io_in_b_bits_address, 
  input  [7:0]  io_in_b_bits_mask, 
  input         io_in_b_bits_corrupt, 
  input         io_in_c_ready, 
  input         io_in_c_valid, 
  input  [2:0]  io_in_c_bits_opcode, 
  input  [2:0]  io_in_c_bits_param, 
  input  [2:0]  io_in_c_bits_size, 
  input  [1:0]  io_in_c_bits_source, 
  input  [31:0] io_in_c_bits_address, 
  input         io_in_c_bits_corrupt, 
  input         io_in_d_ready, 
  input         io_in_d_valid, 
  input  [2:0]  io_in_d_bits_opcode, 
  input  [1:0]  io_in_d_bits_param, 
  input  [2:0]  io_in_d_bits_size, 
  input  [1:0]  io_in_d_bits_source, 
  input  [2:0]  io_in_d_bits_sink, 
  input         io_in_d_bits_denied, 
  input         io_in_d_bits_corrupt, 
  input         io_in_e_ready, 
  input         io_in_e_valid, 
  input  [2:0]  io_in_e_bits_sink 
);

endmodule
*/

// close tlmonitor
`ifndef POSTSIM_EN_MEISHA
//`BIND_MODULE_CLOSE_INIT(TLMonitor)
//`BIND_MODULE_CLOSE_INIT(TLMonitor_10)
`BIND_MODULE_CLOSE_INIT(TLMonitor_11)
//`BIND_MODULE_CLOSE_INIT(TLMonitor_12)
`BIND_MODULE_CLOSE_INIT(TLMonitor_13)
`BIND_MODULE_CLOSE_INIT(TLMonitor_14)
`BIND_MODULE_CLOSE_INIT(TLMonitor_15)
//`BIND_MODULE_CLOSE_INIT(TLMonitor_16)
`BIND_MODULE_CLOSE_INIT(TLMonitor_17)
//`BIND_MODULE_CLOSE_INIT(TLMonitor_18)
`BIND_MODULE_CLOSE_INIT(TLMonitor_19)
//`BIND_MODULE_CLOSE_INIT(TLMonitor_20)
//`BIND_MODULE_CLOSE_INIT(TLMonitor_21)
//`BIND_MODULE_CLOSE_INIT(TLMonitor_22)
`BIND_MODULE_CLOSE_INIT(TLMonitor_23)
//`BIND_MODULE_CLOSE_INIT(TLMonitor_27)
`BIND_MODULE_CLOSE_INIT(TLMonitor_28)
//`BIND_MODULE_CLOSE_INIT(TLMonitor_29)
//`BIND_MODULE_CLOSE_INIT(TLMonitor_30)
//`BIND_MODULE_CLOSE_INIT(TLMonitor_37)
`BIND_MODULE_CLOSE_INIT(TLMonitor_38)
`BIND_MODULE_CLOSE_INIT(TLMonitor_39)
//`BIND_MODULE_CLOSE_INIT(TLMonitor_4)
`BIND_MODULE_CLOSE_INIT(TLMonitor_40)
//`BIND_MODULE_CLOSE_INIT(TLMonitor_41)
//`BIND_MODULE_CLOSE_INIT(TLMonitor_42)
`BIND_MODULE_CLOSE_INIT(TLMonitor_43)
`BIND_MODULE_CLOSE_INIT(TLMonitor_44)
`BIND_MODULE_CLOSE_INIT(TLMonitor_45)
`BIND_MODULE_CLOSE_INIT(TLMonitor_46)
`BIND_MODULE_CLOSE_INIT(TLMonitor_47)
`BIND_MODULE_CLOSE_INIT(TLMonitor_48)
`BIND_MODULE_CLOSE_INIT(TLMonitor_49)
//`BIND_MODULE_CLOSE_INIT(TLMonitor_5)
`BIND_MODULE_CLOSE_INIT(TLMonitor_50)
`BIND_MODULE_CLOSE_INIT(TLMonitor_51)
`BIND_MODULE_CLOSE_INIT(TLMonitor_52)
`BIND_MODULE_CLOSE_INIT(TLMonitor_53)
`BIND_MODULE_CLOSE_INIT(TLMonitor_54)
`BIND_MODULE_CLOSE_INIT(TLMonitor_55)
`BIND_MODULE_CLOSE_INIT(TLMonitor_56)
`BIND_MODULE_CLOSE_INIT(TLMonitor_57)
`BIND_MODULE_CLOSE_INIT(TLMonitor_58)
`BIND_MODULE_CLOSE_INIT(TLMonitor_59)
`BIND_MODULE_CLOSE_INIT(TLMonitor_6)
`BIND_MODULE_CLOSE_INIT(TLMonitor_60)
`BIND_MODULE_CLOSE_INIT(TLMonitor_61)
`BIND_MODULE_CLOSE_INIT(TLMonitor_62)
`BIND_MODULE_CLOSE_INIT(TLMonitor_63)
`ifndef POSTSIM_EN
`BIND_MODULE_CLOSE_INIT(TLMonitor_64)
`BIND_MODULE_CLOSE_INIT(TLMonitor_65)
`BIND_MODULE_CLOSE_INIT(TLMonitor_66)
`endif
`BIND_MODULE_CLOSE_INIT(TLMonitor_7)
`BIND_MODULE_CLOSE_INIT(TLMonitor_77)
`BIND_MODULE_CLOSE_INIT(TLMonitor_78)
`BIND_MODULE_CLOSE_INIT(TLMonitor_79)
//`BIND_MODULE_CLOSE_INIT(TLMonitor_8)
`BIND_MODULE_CLOSE_INIT(TLMonitor_80)
`BIND_MODULE_CLOSE_INIT(TLMonitor_81)
`BIND_MODULE_CLOSE_INIT(TLMonitor_82)
`BIND_MODULE_CLOSE_INIT(TLMonitor_83)
`BIND_MODULE_CLOSE_INIT(TLMonitor_84)
`BIND_MODULE_CLOSE_INIT(TLMonitor_85)
`BIND_MODULE_CLOSE_INIT(TLMonitor_86)
`BIND_MODULE_CLOSE_INIT(TLMonitor_87)
`BIND_MODULE_CLOSE_INIT(TLMonitor_88)
//`BIND_MODULE_CLOSE_INIT(TLMonitor_89)
//`BIND_MODULE_CLOSE_INIT(TLMonitor_9)
`BIND_MODULE_CLOSE_INIT(TLMonitor_90)
`BIND_MODULE_CLOSE_INIT(TLMonitor_91)

`BIND_MODULE_CLOSE_INIT(CHIPLINK_PREFIX_Chiplink_TLMonitor)
`BIND_MODULE_CLOSE_INIT(CHIPLINK_PREFIX_Chiplink_TLMonitor_1)
`BIND_MODULE_CLOSE_INIT(CHIPLINK_PREFIX_Chiplink_TLMonitor_2)
`BIND_MODULE_CLOSE_INIT(CHIPLINK_PREFIX_Chiplink_TLMonitor_3)
`BIND_MODULE_CLOSE_INIT(CHIPLINK_PREFIX_Chiplink_TLMonitor_4)
`BIND_MODULE_CLOSE_INIT(CHIPLINK_PREFIX_Chiplink_TLMonitor_5)
`BIND_MODULE_CLOSE_INIT(CHIPLINK_PREFIX_Chiplink_TLMonitor_6)
`BIND_MODULE_CLOSE_INIT(CHIPLINK_PREFIX_Chiplink_TLMonitor_7)
`BIND_MODULE_CLOSE_INIT(CHIPLINK_PREFIX_Chiplink_TLMonitor_8)
`BIND_MODULE_CLOSE_INIT(CHIPLINK_PREFIX_Chiplink_TLMonitor_9)
`BIND_MODULE_CLOSE_INIT(CHIPLINK_PREFIX_Chiplink_TLMonitor_10)
`BIND_MODULE_CLOSE_INIT(CHIPLINK_PREFIX_Chiplink_TLMonitor_11)
`BIND_MODULE_CLOSE_INIT(CHIPLINK_PREFIX_Chiplink_TLMonitor_12)
`BIND_MODULE_CLOSE_INIT(CHIPLINK_PREFIX_Chiplink_TLMonitor_13)
`BIND_MODULE_CLOSE_INIT(CHIPLINK_PREFIX_Chiplink_TLMonitor_14)
`BIND_MODULE_CLOSE_INIT(CHIPLINK_PREFIX_Chiplink_TLMonitor_15)
`BIND_MODULE_CLOSE_INIT(CHIPLINK_PREFIX_Chiplink_TLMonitor_16)
`endif


module MEISHAV100_TOP_init_bind();

initial begin
/*
   force MEISHAV100_TOP.topDesign.topMod.sbus.control_bus.coupler_to_slave_named_debug.buffer.TLMonitor.clock = 0;
   force MEISHAV100_TOP.topDesign.topMod.sbus.control_bus.coupler_to_slave_named_debug.buffer.TLMonitor.reset = 1;
   //force MEISHAV100_TOP.topDesign.topMod.sbus.control_bus.coupler_to_slave_named_MaskROM.fragmenter.TLMonitor.clock = 0;
   //force MEISHAV100_TOP.topDesign.topMod.sbus.control_bus.coupler_to_slave_named_MaskROM.fragmenter.TLMonitor.reset = 1;
   force MEISHAV100_TOP.topDesign.topMod.sbus.control_bus.coupler_to_slave_named_MaskROM.widget.TLMonitor.clock = 0;
   force MEISHAV100_TOP.topDesign.topMod.sbus.control_bus.coupler_to_slave_named_MaskROM.widget.TLMonitor.reset = 1;
   force MEISHAV100_TOP.topDesign.topMod.sbus.control_bus.coupler_to_slave_named_MaskROM.buffer.TLMonitor.clock = 0;
   force MEISHAV100_TOP.topDesign.topMod.sbus.control_bus.coupler_to_slave_named_MaskROM.buffer.TLMonitor.reset = 1;
   force MEISHAV100_TOP.topDesign.topMod.sbus.coupler_to_bus_named_cbus.fixer.TLMonitor.clock = 0;
   force MEISHAV100_TOP.topDesign.topMod.sbus.coupler_to_bus_named_cbus.fixer.TLMonitor.reset = 1;
   force MEISHAV100_TOP.topDesign.topMod.sbus.coupler_to_bus_named_cbus.widget.TLMonitor.clock = 0;
   force MEISHAV100_TOP.topDesign.topMod.sbus.coupler_to_bus_named_cbus.widget.TLMonitor.reset = 1;
   force MEISHAV100_TOP.topDesign.topMod.sbus.coupler_to_bus_named_cbus.buffer.TLMonitor.clock = 0;
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
   force MEISHAV100_TOP.topDesign.topMod.pbus.coupler_to_device_named_gpio_0.fragmenter.TLMonitor.clock = 0;
   force MEISHAV100_TOP.topDesign.topMod.pbus.coupler_to_device_named_gpio_0.fragmenter.TLMonitor.reset = 1;
   force MEISHAV100_TOP.topDesign.topMod.bh.TLMonitor.clock = 0;
   force MEISHAV100_TOP.topDesign.topMod.bh.TLMonitor.reset = 1;
   force MEISHAV100_TOP.topDesign.topMod.ww.TLMonitor.clock = 0;
   force MEISHAV100_TOP.topDesign.topMod.ww.TLMonitor.reset = 1;
   force MEISHAV100_TOP.topDesign.topMod.mbus.memory_bus_xbar.TLMonitor.clock = 0;
   force MEISHAV100_TOP.topDesign.topMod.mbus.memory_bus_xbar.TLMonitor.reset = 1;
   force MEISHAV100_TOP.topDesign.topMod.mbus.coupler_from_coherence_manager.binder.TLMonitor.clock = 0;
   force MEISHAV100_TOP.topDesign.topMod.mbus.coupler_from_coherence_manager.binder.TLMonitor.reset = 1;
   force MEISHAV100_TOP.topDesign.topMod.mbus.coupler_to_memory_controller_named_xilinxvc707mig.buffer.TLMonitor.clock = 0;
   force MEISHAV100_TOP.topDesign.topMod.mbus.coupler_to_memory_controller_named_xilinxvc707mig.buffer.TLMonitor.reset = 1;
   force MEISHAV100_TOP.topDesign.topMod.mbus.coupler_to_memory_controller_named_xilinxvc707mig.picker.TLMonitor.clock = 0;
   force MEISHAV100_TOP.topDesign.topMod.mbus.coupler_to_memory_controller_named_xilinxvc707mig.picker.TLMonitor.reset = 1;
   force MEISHAV100_TOP.topDesign.topMod.sbus.control_bus.out_xbar.TLMonitor.clock = 0;
   force MEISHAV100_TOP.topDesign.topMod.sbus.control_bus.out_xbar.TLMonitor.reset = 1;
   force MEISHAV100_TOP.topDesign.topMod.plic.TLMonitor.clock = 0;
   force MEISHAV100_TOP.topDesign.topMod.plic.TLMonitor.reset = 1;
   force MEISHAV100_TOP.topDesign.topMod.clint.TLMonitor.clock = 0;
   force MEISHAV100_TOP.topDesign.topMod.clint.TLMonitor.reset = 1;
   force MEISHAV100_TOP.topDesign.topMod.debug_1.dmOuter.dmiXbar.TLMonitor.clock = 0;
   force MEISHAV100_TOP.topDesign.topMod.debug_1.dmOuter.dmiXbar.TLMonitor.reset = 1;
   force MEISHAV100_TOP.topDesign.topMod.debug_1.dmOuter.dmOuter.TLMonitor.clock = 0;
   force MEISHAV100_TOP.topDesign.topMod.debug_1.dmOuter.dmOuter.TLMonitor.reset = 1;
   force MEISHAV100_TOP.topDesign.topMod.debug_1.dmOuter.asource.TLMonitor.clock = 0;
   force MEISHAV100_TOP.topDesign.topMod.debug_1.dmOuter.asource.TLMonitor.reset = 1;
   force MEISHAV100_TOP.topDesign.topMod.debug_1.dmInner.dmInner.TLMonitor.clock = 0;
   force MEISHAV100_TOP.topDesign.topMod.debug_1.dmInner.dmInner.TLMonitor.reset = 1;
   force MEISHAV100_TOP.topDesign.topMod.debug_1.dmInner.dmInner.TLMonitor_1.clock = 0;
   force MEISHAV100_TOP.topDesign.topMod.debug_1.dmInner.dmInner.TLMonitor_1.reset = 1;
   force MEISHAV100_TOP.topDesign.topMod.tile.tlMasterXbar.TLMonitor.clock = 0;
   force MEISHAV100_TOP.topDesign.topMod.tile.tlMasterXbar.TLMonitor.reset = 1;
   force MEISHAV100_TOP.topDesign.topMod.tile_1.tlMasterXbar.TLMonitor.clock = 0;
   force MEISHAV100_TOP.topDesign.topMod.tile_1.tlMasterXbar.TLMonitor.reset = 1;
   force MEISHAV100_TOP.topDesign.topMod.tile_2.tlMasterXbar.TLMonitor.clock = 0;
   force MEISHAV100_TOP.topDesign.topMod.tile_2.tlMasterXbar.TLMonitor.reset = 1;
   force MEISHAV100_TOP.topDesign.topMod.tile_3.tlMasterXbar.TLMonitor.clock = 0;
   force MEISHAV100_TOP.topDesign.topMod.tile_3.tlMasterXbar.TLMonitor.reset = 1;
   force MEISHAV100_TOP.topDesign.topMod.tile.tlMasterXbar.TLMonitor_1.clock = 0;
   force MEISHAV100_TOP.topDesign.topMod.tile.tlMasterXbar.TLMonitor_1.reset = 1;
   force MEISHAV100_TOP.topDesign.topMod.tile_1.tlMasterXbar.TLMonitor_1.clock = 0;
   force MEISHAV100_TOP.topDesign.topMod.tile_1.tlMasterXbar.TLMonitor_1.reset = 1;
   force MEISHAV100_TOP.topDesign.topMod.tile_2.tlMasterXbar.TLMonitor_1.clock = 0;
   force MEISHAV100_TOP.topDesign.topMod.tile_2.tlMasterXbar.TLMonitor_1.reset = 1;
   force MEISHAV100_TOP.topDesign.topMod.tile_3.tlMasterXbar.TLMonitor_1.clock = 0;
   force MEISHAV100_TOP.topDesign.topMod.tile_3.tlMasterXbar.TLMonitor_1.reset = 1;
   force MEISHAV100_TOP.topDesign.topMod.tile.buffer.TLMonitor.clock = 0;
   force MEISHAV100_TOP.topDesign.topMod.tile.buffer.TLMonitor.reset = 1;
   force MEISHAV100_TOP.topDesign.topMod.tile_1.buffer.TLMonitor.clock = 0;
   force MEISHAV100_TOP.topDesign.topMod.tile_1.buffer.TLMonitor.reset = 1;
   force MEISHAV100_TOP.topDesign.topMod.tile_2.buffer.TLMonitor.clock = 0;
   force MEISHAV100_TOP.topDesign.topMod.tile_2.buffer.TLMonitor.reset = 1;
   force MEISHAV100_TOP.topDesign.topMod.tile_3.buffer.TLMonitor.clock = 0;
   force MEISHAV100_TOP.topDesign.topMod.tile_3.buffer.TLMonitor.reset = 1;
   force MEISHAV100_TOP.topDesign.topMod.sbus.control_bus.buffer.TLMonitor.clock = 0;
   force MEISHAV100_TOP.topDesign.topMod.sbus.control_bus.buffer.TLMonitor.reset = 1;
   //force MEISHAV100_TOP.topDesign.topMod.maskROM.TLMonitor.clock = 0;
   //force MEISHAV100_TOP.topDesign.topMod.maskROM.TLMonitor.reset = 1;
   force MEISHAV100_TOP.topDesign.topMod.sbus.control_bus.atomics.TLMonitor.clock = 0;
   force MEISHAV100_TOP.topDesign.topMod.sbus.control_bus.atomics.TLMonitor.reset = 1;
   force MEISHAV100_TOP.topDesign.topMod.uart_0.buffer.TLMonitor.clock = 0;
   force MEISHAV100_TOP.topDesign.topMod.uart_0.buffer.TLMonitor.reset = 1;
   force MEISHAV100_TOP.topDesign.topMod.uart_0.TLMonitor.clock = 0;
   force MEISHAV100_TOP.topDesign.topMod.uart_0.TLMonitor.reset = 1;
   force MEISHAV100_TOP.topDesign.topMod.spi_0.buffer.TLMonitor.clock = 0;
   force MEISHAV100_TOP.topDesign.topMod.spi_0.buffer.TLMonitor.reset = 1;
   force MEISHAV100_TOP.topDesign.topMod.spi_0.TLMonitor.clock = 0;
   force MEISHAV100_TOP.topDesign.topMod.spi_0.TLMonitor.reset = 1;
   force MEISHAV100_TOP.topDesign.topMod.gpio_0.buffer.TLMonitor.clock = 0;
   force MEISHAV100_TOP.topDesign.topMod.gpio_0.buffer.TLMonitor.reset = 1;
   force MEISHAV100_TOP.topDesign.topMod.gpio_0.TLMonitor.clock = 0;
   force MEISHAV100_TOP.topDesign.topMod.gpio_0.TLMonitor.reset = 1;
   force MEISHAV100_TOP.topDesign.topMod.sbus.control_bus.buffer_1.TLMonitor.clock = 0;
   force MEISHAV100_TOP.topDesign.topMod.sbus.control_bus.buffer_1.TLMonitor.reset = 1;
   force MEISHAV100_TOP.topDesign.topMod.sbus.control_bus.coupler_to_bus_named_pbus.widget.TLMonitor.clock = 0;
   force MEISHAV100_TOP.topDesign.topMod.sbus.control_bus.coupler_to_bus_named_pbus.widget.TLMonitor.reset = 1;

*/

end

endmodule

// close tlmonitor
bind MEISHAV100_TOP MEISHAV100_TOP_init_bind u_MEISHAV100_TOP_init_bind();
