SUAT-lhy/MEISHA-V100-A-Silicon-Proven-Quad-Core-RISC-V-SoC/trunk/hw/d2dv100_top_spi/rtl/ip/SRAM_CTRL.v

module SRAM_CTRL #(
  parameter RAM_WIDTH = 64
  ,parameter MASK_DEPTH = RAM_WIDTH/8
  ,parameter RAM_DEPTH = 32'h10_0000
  ,parameter ADDRESS_DEPTH = $clog2(RAM_DEPTH/MASK_DEPTH)
  ,parameter SOURCE_WIDTH = 6
  ) ( // @[:sifive.freedom.unleashed.DevKitU500FPGADesign_WithDevKit50MHz.fir@256257.2]
  input         clock, // @[:sifive.freedom.unleashed.DevKitU500FPGADesign_WithDevKit50MHz.fir@256258.4]
  input         reset, // @[:sifive.freedom.unleashed.DevKitU500FPGADesign_WithDevKit50MHz.fir@256259.4]
  output        io_enq_ready, // @[:sifive.freedom.unleashed.DevKitU500FPGADesign_WithDevKit50MHz.fir@256260.4]
  input         io_enq_valid, // @[:sifive.freedom.unleashed.DevKitU500FPGADesign_WithDevKit50MHz.fir@256260.4]
  input  [2:0]  io_enq_bits_opcode, // @[:sifive.freedom.unleashed.DevKitU500FPGADesign_WithDevKit50MHz.fir@256260.4]
  input  [2:0]  io_enq_bits_param, // @[:sifive.freedom.unleashed.DevKitU500FPGADesign_WithDevKit50MHz.fir@256260.4]
  input  [2:0]  io_enq_bits_size, // @[:sifive.freedom.unleashed.DevKitU500FPGADesign_WithDevKit50MHz.fir@256260.4]
  input  [SOURCE_WIDTH-1:0]  io_enq_bits_source, // @[:sifive.freedom.unleashed.DevKitU500FPGADesign_WithDevKit50MHz.fir@256260.4]
  input  [ADDRESS_DEPTH-1:0] io_enq_bits_address, // @[:sifive.freedom.unleashed.DevKitU500FPGADesign_WithDevKit50MHz.fir@256260.4]
  input  [7:0]  io_enq_bits_mask, // @[:sifive.freedom.unleashed.DevKitU500FPGADesign_WithDevKit50MHz.fir@256260.4]
  input  [63:0] io_enq_bits_data, // @[:sifive.freedom.unleashed.DevKitU500FPGADesign_WithDevKit50MHz.fir@256260.4]
  input         io_enq_bits_corrupt, // @[:sifive.freedom.unleashed.DevKitU500FPGADesign_WithDevKit50MHz.fir@256260.4]
  input         io_deq_ready, // @[:sifive.freedom.unleashed.DevKitU500FPGADesign_WithDevKit50MHz.fir@256260.4]
  output        io_deq_valid, // @[:sifive.freedom.unleashed.DevKitU500FPGADesign_WithDevKit50MHz.fir@256260.4]
  output [2:0]  io_deq_bits_opcode, // @[:sifive.freedom.unleashed.DevKitU500FPGADesign_WithDevKit50MHz.fir@256260.4]
  output [2:0]  io_deq_bits_param, // @[:sifive.freedom.unleashed.DevKitU500FPGADesign_WithDevKit50MHz.fir@256260.4]
  output [2:0]  io_deq_bits_size, // @[:sifive.freedom.unleashed.DevKitU500FPGADesign_WithDevKit50MHz.fir@256260.4]
  output [SOURCE_WIDTH-1:0]  io_deq_bits_source, // @[:sifive.freedom.unleashed.DevKitU500FPGADesign_WithDevKit50MHz.fir@256260.4]
  output [ADDRESS_DEPTH-1:0] io_deq_bits_address, // @[:sifive.freedom.unleashed.DevKitU500FPGADesign_WithDevKit50MHz.fir@256260.4]
  output [7:0]  io_deq_bits_mask, // @[:sifive.freedom.unleashed.DevKitU500FPGADesign_WithDevKit50MHz.fir@256260.4]
  output [63:0] io_deq_bits_data, // @[:sifive.freedom.unleashed.DevKitU500FPGADesign_WithDevKit50MHz.fir@256260.4]
  output        io_deq_bits_corrupt // @[:sifive.freedom.unleashed.DevKitU500FPGADesign_WithDevKit50MHz.fir@256260.4]
);
  reg [2:0] _T_35_opcode [0:1]; // @[Decoupled.scala 214:24:sifive.freedom.unleashed.DevKitU500FPGADesign_WithDevKit50MHz.fir@256262.4]
  reg [31:0] _RAND_0;
  wire [2:0] _T_35_opcode__T_58_data; // @[Decoupled.scala 214:24:sifive.freedom.unleashed.DevKitU500FPGADesign_WithDevKit50MHz.fir@256262.4]
  wire  _T_35_opcode__T_58_addr; // @[Decoupled.scala 214:24:sifive.freedom.unleashed.DevKitU500FPGADesign_WithDevKit50MHz.fir@256262.4]
  wire [2:0] _T_35_opcode__T_50_data; // @[Decoupled.scala 214:24:sifive.freedom.unleashed.DevKitU500FPGADesign_WithDevKit50MHz.fir@256262.4]
  wire  _T_35_opcode__T_50_addr; // @[Decoupled.scala 214:24:sifive.freedom.unleashed.DevKitU500FPGADesign_WithDevKit50MHz.fir@256262.4]
  wire  _T_35_opcode__T_50_mask; // @[Decoupled.scala 214:24:sifive.freedom.unleashed.DevKitU500FPGADesign_WithDevKit50MHz.fir@256262.4]
  wire  _T_35_opcode__T_50_en; // @[Decoupled.scala 214:24:sifive.freedom.unleashed.DevKitU500FPGADesign_WithDevKit50MHz.fir@256262.4]
  reg [2:0] _T_35_param [0:1]; // @[Decoupled.scala 214:24:sifive.freedom.unleashed.DevKitU500FPGADesign_WithDevKit50MHz.fir@256262.4]
  reg [31:0] _RAND_1;
  wire [2:0] _T_35_param__T_58_data; // @[Decoupled.scala 214:24:sifive.freedom.unleashed.DevKitU500FPGADesign_WithDevKit50MHz.fir@256262.4]
  wire  _T_35_param__T_58_addr; // @[Decoupled.scala 214:24:sifive.freedom.unleashed.DevKitU500FPGADesign_WithDevKit50MHz.fir@256262.4]
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
  wire  _T_35_mask__T_50_addr; // @[Decoupled.scala 214:24:sifive.freedom.unleashed.DevKitU500FPGADesign_WithDevKit50MHz.fir@256262.4]
  wire  _T_35_mask__T_50_mask; // @[Decoupled.scala 214:24:sifive.freedom.unleashed.DevKitU500FPGADesign_WithDevKit50MHz.fir@256262.4]
  wire  _T_35_mask__T_50_en; // @[Decoupled.scala 214:24:sifive.freedom.unleashed.DevKitU500FPGADesign_WithDevKit50MHz.fir@256262.4]
  reg [63:0] _T_35_data [0:RAM_DEPTH-1]; // @[Decoupled.scala 214:24:sifive.freedom.unleashed.DevKitU500FPGADesign_WithDevKit50MHz.fir@256262.4]
  reg [63:0] _RAND_6;
  wire [63:0] _T_35_data__T_58_data; // @[Decoupled.scala 214:24:sifive.freedom.unleashed.DevKitU500FPGADesign_WithDevKit50MHz.fir@256262.4]
  wire  _T_35_data__T_58_addr; // @[Decoupled.scala 214:24:sifive.freedom.unleashed.DevKitU500FPGADesign_WithDevKit50MHz.fir@256262.4]
  wire [63:0] _T_35_data__T_50_data; // @[Decoupled.scala 214:24:sifive.freedom.unleashed.DevKitU500FPGADesign_WithDevKit50MHz.fir@256262.4]
  wire  _T_35_data__T_50_addr; // @[Decoupled.scala 214:24:sifive.freedom.unleashed.DevKitU500FPGADesign_WithDevKit50MHz.fir@256262.4]
  wire  _T_35_data__T_50_mask; // @[Decoupled.scala 214:24:sifive.freedom.unleashed.DevKitU500FPGADesign_WithDevKit50MHz.fir@256262.4]
  wire  _T_35_data__T_50_en; // @[Decoupled.scala 214:24:sifive.freedom.unleashed.DevKitU500FPGADesign_WithDevKit50MHz.fir@256262.4]
  reg  _T_35_corrupt [0:1]; // @[Decoupled.scala 214:24:sifive.freedom.unleashed.DevKitU500FPGADesign_WithDevKit50MHz.fir@256262.4]
  reg [31:0] _RAND_7;
  wire  _T_35_corrupt__T_58_data; // @[Decoupled.scala 214:24:sifive.freedom.unleashed.DevKitU500FPGADesign_WithDevKit50MHz.fir@256262.4]
  wire  _T_35_corrupt__T_58_addr; // @[Decoupled.scala 214:24:sifive.freedom.unleashed.DevKitU500FPGADesign_WithDevKit50MHz.fir@256262.4]
  wire  _T_35_corrupt__T_50_data; // @[Decoupled.scala 214:24:sifive.freedom.unleashed.DevKitU500FPGADesign_WithDevKit50MHz.fir@256262.4]
  wire  _T_35_corrupt__T_50_addr; // @[Decoupled.scala 214:24:sifive.freedom.unleashed.DevKitU500FPGADesign_WithDevKit50MHz.fir@256262.4]
  wire  _T_35_corrupt__T_50_mask; // @[Decoupled.scala 214:24:sifive.freedom.unleashed.DevKitU500FPGADesign_WithDevKit50MHz.fir@256262.4]
  wire  _T_35_corrupt__T_50_en; // @[Decoupled.scala 214:24:sifive.freedom.unleashed.DevKitU500FPGADesign_WithDevKit50MHz.fir@256262.4]
  reg  value; // @[Counter.scala 26:33:sifive.freedom.unleashed.DevKitU500FPGADesign_WithDevKit50MHz.fir@256263.4]
  reg [31:0] _RAND_8;
  reg  value_1; // @[Counter.scala 26:33:sifive.freedom.unleashed.DevKitU500FPGADesign_WithDevKit50MHz.fir@256264.4]
  reg [31:0] _RAND_9;
  reg  _T_39; // @[Decoupled.scala 217:35:sifive.freedom.unleashed.DevKitU500FPGADesign_WithDevKit50MHz.fir@256265.4]
  reg [31:0] _RAND_10;
  wire  _T_40; // @[Decoupled.scala 219:41:sifive.freedom.unleashed.DevKitU500FPGADesign_WithDevKit50MHz.fir@256266.4]
  wire  _T_41; // @[Decoupled.scala 220:36:sifive.freedom.unleashed.DevKitU500FPGADesign_WithDevKit50MHz.fir@256267.4]
  wire  _T_42; // @[Decoupled.scala 220:33:sifive.freedom.unleashed.DevKitU500FPGADesign_WithDevKit50MHz.fir@256268.4]
  wire  _T_43; // @[Decoupled.scala 221:32:sifive.freedom.unleashed.DevKitU500FPGADesign_WithDevKit50MHz.fir@256269.4]
  wire  _T_44; // @[Decoupled.scala 37:37:sifive.freedom.unleashed.DevKitU500FPGADesign_WithDevKit50MHz.fir@256270.4]
  wire  _T_47; // @[Decoupled.scala 37:37:sifive.freedom.unleashed.DevKitU500FPGADesign_WithDevKit50MHz.fir@256273.4]
  wire  _T_52; // @[Counter.scala 35:22:sifive.freedom.unleashed.DevKitU500FPGADesign_WithDevKit50MHz.fir@256288.6]
  wire  _T_54; // @[Counter.scala 35:22:sifive.freedom.unleashed.DevKitU500FPGADesign_WithDevKit50MHz.fir@256294.6]
  wire  _T_55; // @[Decoupled.scala 232:16:sifive.freedom.unleashed.DevKitU500FPGADesign_WithDevKit50MHz.fir@256297.4]
  assign _T_35_opcode__T_58_addr = value_1;
  assign _T_35_opcode__T_58_data = _T_35_opcode[_T_35_opcode__T_58_addr]; // @[Decoupled.scala 214:24:sifive.freedom.unleashed.DevKitU500FPGADesign_WithDevKit50MHz.fir@256262.4]
  assign _T_35_opcode__T_50_data = io_enq_bits_opcode;
  assign _T_35_opcode__T_50_addr = value;
  assign _T_35_opcode__T_50_mask = 1'h1;
  assign _T_35_opcode__T_50_en = io_enq_ready & io_enq_valid;
  assign _T_35_param__T_58_addr = value_1;
  assign _T_35_param__T_58_data = _T_35_param[_T_35_param__T_58_addr]; // @[Decoupled.scala 214:24:sifive.freedom.unleashed.DevKitU500FPGADesign_WithDevKit50MHz.fir@256262.4]
  assign _T_35_param__T_50_data = io_enq_bits_param;
  assign _T_35_param__T_50_addr = value;
  assign _T_35_param__T_50_mask = 1'h1;
  assign _T_35_param__T_50_en = io_enq_ready & io_enq_valid;
  assign _T_35_size__T_58_addr = value_1;
  assign _T_35_size__T_58_data = _T_35_size[_T_35_size__T_58_addr]; // @[Decoupled.scala 214:24:sifive.freedom.unleashed.DevKitU500FPGADesign_WithDevKit50MHz.fir@256262.4]
  assign _T_35_size__T_50_data = io_enq_bits_size;
  assign _T_35_size__T_50_addr = value;
  assign _T_35_size__T_50_mask = 1'h1;
  assign _T_35_size__T_50_en = io_enq_ready & io_enq_valid;
  assign _T_35_source__T_58_addr = value_1;
  assign _T_35_source__T_58_data = _T_35_source[_T_35_source__T_58_addr]; // @[Decoupled.scala 214:24:sifive.freedom.unleashed.DevKitU500FPGADesign_WithDevKit50MHz.fir@256262.4]
  assign _T_35_source__T_50_data = io_enq_bits_source;
  assign _T_35_source__T_50_addr = value;
  assign _T_35_source__T_50_mask = 1'h1;
  assign _T_35_source__T_50_en = io_enq_ready & io_enq_valid;
  assign _T_35_address__T_58_addr = value_1;
  assign _T_35_address__T_58_data = _T_35_address[_T_35_address__T_58_addr]; // @[Decoupled.scala 214:24:sifive.freedom.unleashed.DevKitU500FPGADesign_WithDevKit50MHz.fir@256262.4]
  assign _T_35_address__T_50_data = io_enq_bits_address;
  assign _T_35_address__T_50_addr = value;
  assign _T_35_address__T_50_mask = 1'h1;
  assign _T_35_address__T_50_en = io_enq_ready & io_enq_valid;
  assign _T_35_mask__T_58_addr = value_1;
  assign _T_35_mask__T_58_data = _T_35_mask[_T_35_mask__T_58_addr]; // @[Decoupled.scala 214:24:sifive.freedom.unleashed.DevKitU500FPGADesign_WithDevKit50MHz.fir@256262.4]
  assign _T_35_mask__T_50_data = io_enq_bits_mask;
  assign _T_35_mask__T_50_addr = value;
  assign _T_35_mask__T_50_mask = 1'h1;
  assign _T_35_mask__T_50_en = io_enq_ready & io_enq_valid;
  assign _T_35_data__T_58_addr = value_1;
  assign _T_35_data__T_58_data = _T_35_data[_T_35_address__T_58_data]; // @[Decoupled.scala 214:24:sifive.freedom.unleashed.DevKitU500FPGADesign_WithDevKit50MHz.fir@256262.4]
  assign _T_35_data__T_50_data = io_enq_bits_data;
  assign _T_35_data__T_50_addr = value;
  assign _T_35_data__T_50_mask = 1'h1;
  assign _T_35_data__T_50_en = io_enq_ready & io_enq_valid;
  assign _T_35_corrupt__T_58_addr = value_1;
  assign _T_35_corrupt__T_58_data = _T_35_corrupt[_T_35_corrupt__T_58_addr]; // @[Decoupled.scala 214:24:sifive.freedom.unleashed.DevKitU500FPGADesign_WithDevKit50MHz.fir@256262.4]
  assign _T_35_corrupt__T_50_data = io_enq_bits_corrupt;
  assign _T_35_corrupt__T_50_addr = value;
  assign _T_35_corrupt__T_50_mask = 1'h1;
  assign _T_35_corrupt__T_50_en = io_enq_ready & io_enq_valid;
  assign _T_40 = value == value_1; // @[Decoupled.scala 219:41:sifive.freedom.unleashed.DevKitU500FPGADesign_WithDevKit50MHz.fir@256266.4]
  assign _T_41 = _T_39 == 1'h0; // @[Decoupled.scala 220:36:sifive.freedom.unleashed.DevKitU500FPGADesign_WithDevKit50MHz.fir@256267.4]
  assign _T_42 = _T_40 & _T_41; // @[Decoupled.scala 220:33:sifive.freedom.unleashed.DevKitU500FPGADesign_WithDevKit50MHz.fir@256268.4]
  assign _T_43 = _T_40 & _T_39; // @[Decoupled.scala 221:32:sifive.freedom.unleashed.DevKitU500FPGADesign_WithDevKit50MHz.fir@256269.4]
  assign _T_44 = io_enq_ready & io_enq_valid; // @[Decoupled.scala 37:37:sifive.freedom.unleashed.DevKitU500FPGADesign_WithDevKit50MHz.fir@256270.4]
  assign _T_47 = io_deq_ready & io_deq_valid; // @[Decoupled.scala 37:37:sifive.freedom.unleashed.DevKitU500FPGADesign_WithDevKit50MHz.fir@256273.4]
  assign _T_52 = value + 1'h1; // @[Counter.scala 35:22:sifive.freedom.unleashed.DevKitU500FPGADesign_WithDevKit50MHz.fir@256288.6]
  assign _T_54 = value_1 + 1'h1; // @[Counter.scala 35:22:sifive.freedom.unleashed.DevKitU500FPGADesign_WithDevKit50MHz.fir@256294.6]
  assign _T_55 = _T_44 != _T_47; // @[Decoupled.scala 232:16:sifive.freedom.unleashed.DevKitU500FPGADesign_WithDevKit50MHz.fir@256297.4]
  assign io_enq_ready = _T_43 == 1'h0; // @[Decoupled.scala 237:16:sifive.freedom.unleashed.DevKitU500FPGADesign_WithDevKit50MHz.fir@256304.4]
  assign io_deq_valid = _T_42 == 1'h0; // @[Decoupled.scala 236:16:sifive.freedom.unleashed.DevKitU500FPGADesign_WithDevKit50MHz.fir@256302.4]
  assign io_deq_bits_opcode = _T_35_opcode__T_58_data; // @[Decoupled.scala 238:15:sifive.freedom.unleashed.DevKitU500FPGADesign_WithDevKit50MHz.fir@256313.4]
  assign io_deq_bits_param = _T_35_param__T_58_data; // @[Decoupled.scala 238:15:sifive.freedom.unleashed.DevKitU500FPGADesign_WithDevKit50MHz.fir@256312.4]
  assign io_deq_bits_size = _T_35_size__T_58_data; // @[Decoupled.scala 238:15:sifive.freedom.unleashed.DevKitU500FPGADesign_WithDevKit50MHz.fir@256311.4]
  assign io_deq_bits_source = _T_35_source__T_58_data; // @[Decoupled.scala 238:15:sifive.freedom.unleashed.DevKitU500FPGADesign_WithDevKit50MHz.fir@256310.4]
  assign io_deq_bits_address = _T_35_address__T_58_data; // @[Decoupled.scala 238:15:sifive.freedom.unleashed.DevKitU500FPGADesign_WithDevKit50MHz.fir@256309.4]
  assign io_deq_bits_mask = _T_35_mask__T_58_data; // @[Decoupled.scala 238:15:sifive.freedom.unleashed.DevKitU500FPGADesign_WithDevKit50MHz.fir@256308.4]
  assign io_deq_bits_data = _T_35_data__T_58_data; // @[Decoupled.scala 238:15:sifive.freedom.unleashed.DevKitU500FPGADesign_WithDevKit50MHz.fir@256307.4]
  assign io_deq_bits_corrupt = _T_35_corrupt__T_58_data; // @[Decoupled.scala 238:15:sifive.freedom.unleashed.DevKitU500FPGADesign_WithDevKit50MHz.fir@256306.4]
`ifdef RANDOMIZE_GARBAGE_ASSIGN
`define RANDOMIZE
`endif
`ifdef RANDOMIZE_INVALID_ASSIGN
`define RANDOMIZE
`endif
`ifdef RANDOMIZE_REG_INIT
`define RANDOMIZE
`endif
`ifdef RANDOMIZE_MEM_INIT
`define RANDOMIZE
`endif
`ifndef RANDOM
`define RANDOM $random
`endif
`ifdef RANDOMIZE
  integer initvar;
  initial begin
    `ifdef INIT_RANDOM
      `INIT_RANDOM
    `endif
    `ifndef VERILATOR
      `ifdef RANDOMIZE_DELAY
        #`RANDOMIZE_DELAY begin end
      `else
        #0.002 begin end
      `endif
    `endif
  _RAND_0 = {1{`RANDOM}};
  `ifdef RANDOMIZE_MEM_INIT
  for (initvar = 0; initvar < RAM_DEPTH; initvar = initvar+1)
    _T_35_opcode[initvar] = _RAND_0[2:0];
  `endif // RANDOMIZE_MEM_INIT
  _RAND_1 = {1{`RANDOM}};
  `ifdef RANDOMIZE_MEM_INIT
  for (initvar = 0; initvar < RAM_DEPTH; initvar = initvar+1)
    _T_35_param[initvar] = _RAND_1[2:0];
  `endif // RANDOMIZE_MEM_INIT
  _RAND_2 = {1{`RANDOM}};
  `ifdef RANDOMIZE_MEM_INIT
  for (initvar = 0; initvar < RAM_DEPTH; initvar = initvar+1)
    _T_35_size[initvar] = _RAND_2[2:0];
  `endif // RANDOMIZE_MEM_INIT
  _RAND_3 = {1{`RANDOM}};
  `ifdef RANDOMIZE_MEM_INIT
  for (initvar = 0; initvar < RAM_DEPTH; initvar = initvar+1)
    _T_35_source[initvar] = _RAND_3[1:0];
  `endif // RANDOMIZE_MEM_INIT
  _RAND_4 = {1{`RANDOM}};
  `ifdef RANDOMIZE_MEM_INIT
  for (initvar = 0; initvar < RAM_DEPTH; initvar = initvar+1)
    _T_35_address[initvar] = _RAND_4[31:0];
  `endif // RANDOMIZE_MEM_INIT
  _RAND_5 = {1{`RANDOM}};
  `ifdef RANDOMIZE_MEM_INIT
  for (initvar = 0; initvar < RAM_DEPTH; initvar = initvar+1)
    _T_35_mask[initvar] = _RAND_5[7:0];
  `endif // RANDOMIZE_MEM_INIT
  _RAND_6 = {2{`RANDOM}};
  `ifdef RANDOMIZE_MEM_INIT
  for (initvar = 0; initvar < RAM_DEPTH; initvar = initvar+1)
    _T_35_data[initvar] = _RAND_6[63:0];
  `endif // RANDOMIZE_MEM_INIT
  _RAND_7 = {1{`RANDOM}};
  `ifdef RANDOMIZE_MEM_INIT
  for (initvar = 0; initvar < RAM_DEPTH; initvar = initvar+1)
    _T_35_corrupt[initvar] = _RAND_7[0:0];
  `endif // RANDOMIZE_MEM_INIT
  `ifdef RANDOMIZE_REG_INIT
  _RAND_8 = {1{`RANDOM}};
  value = _RAND_8[0:0];
  `endif // RANDOMIZE_REG_INIT
  `ifdef RANDOMIZE_REG_INIT
  _RAND_9 = {1{`RANDOM}};
  value_1 = _RAND_9[0:0];
  `endif // RANDOMIZE_REG_INIT
  `ifdef RANDOMIZE_REG_INIT
  _RAND_10 = {1{`RANDOM}};
  _T_39 = _RAND_10[0:0];
  `endif // RANDOMIZE_REG_INIT
  end
`endif // RANDOMIZE
  always @(posedge clock) begin
    if(_T_35_opcode__T_50_en & _T_35_opcode__T_50_mask) begin
      _T_35_opcode[_T_35_opcode__T_50_addr] <= _T_35_opcode__T_50_data; // @[Decoupled.scala 214:24:sifive.freedom.unleashed.DevKitU500FPGADesign_WithDevKit50MHz.fir@256262.4]
    end
    if(_T_35_param__T_50_en & _T_35_param__T_50_mask) begin
      _T_35_param[_T_35_param__T_50_addr] <= _T_35_param__T_50_data; // @[Decoupled.scala 214:24:sifive.freedom.unleashed.DevKitU500FPGADesign_WithDevKit50MHz.fir@256262.4]
    end
    if(_T_35_size__T_50_en & _T_35_size__T_50_mask) begin
      _T_35_size[_T_35_size__T_50_addr] <= _T_35_size__T_50_data; // @[Decoupled.scala 214:24:sifive.freedom.unleashed.DevKitU500FPGADesign_WithDevKit50MHz.fir@256262.4]
    end
    if(_T_35_source__T_50_en & _T_35_source__T_50_mask) begin
      _T_35_source[_T_35_source__T_50_addr] <= _T_35_source__T_50_data; // @[Decoupled.scala 214:24:sifive.freedom.unleashed.DevKitU500FPGADesign_WithDevKit50MHz.fir@256262.4]
    end
    if(_T_35_address__T_50_en & _T_35_address__T_50_mask) begin
      _T_35_address[_T_35_address__T_50_addr] <= _T_35_address__T_50_data; // @[Decoupled.scala 214:24:sifive.freedom.unleashed.DevKitU500FPGADesign_WithDevKit50MHz.fir@256262.4]
    end
    if(_T_35_mask__T_50_en & _T_35_mask__T_50_mask) begin
      _T_35_mask[_T_35_mask__T_50_addr] <= _T_35_mask__T_50_data; // @[Decoupled.scala 214:24:sifive.freedom.unleashed.DevKitU500FPGADesign_WithDevKit50MHz.fir@256262.4]
    end
    if(_T_35_data__T_50_en & _T_35_data__T_50_mask) begin
      _T_35_data[_T_35_data__T_50_addr] <= _T_35_data__T_50_data; // @[Decoupled.scala 214:24:sifive.freedom.unleashed.DevKitU500FPGADesign_WithDevKit50MHz.fir@256262.4]
    end
    if(_T_35_corrupt__T_50_en & _T_35_corrupt__T_50_mask) begin
      _T_35_corrupt[_T_35_corrupt__T_50_addr] <= _T_35_corrupt__T_50_data; // @[Decoupled.scala 214:24:sifive.freedom.unleashed.DevKitU500FPGADesign_WithDevKit50MHz.fir@256262.4]
    end
    if (reset) begin
      value <= 1'h0;
    end else begin
      if (_T_44) begin
        value <= _T_52;
      end
    end
    if (reset) begin
      value_1 <= 1'h0;
    end else begin
      if (_T_47) begin
        value_1 <= _T_54;
      end
    end
    if (reset) begin
      _T_39 <= 1'h0;
    end else begin
      if (_T_55) begin
        _T_39 <= _T_44;
      end
    end
  end
endmodule
