SUAT-lhy/MEISHA-V100-A-Silicon-Proven-Quad-Core-RISC-V-SoC/trunk/hw/d2dv100_top/rtl/openCelerityRocketTile/BTB.v

module BTB( // @[:sifive.freedom.unleashed.DevKitU500FPGADesign_WithDevKit50MHz.fir@289134.2]
  input         clock, // @[:sifive.freedom.unleashed.DevKitU500FPGADesign_WithDevKit50MHz.fir@289135.4]
  input         reset, // @[:sifive.freedom.unleashed.DevKitU500FPGADesign_WithDevKit50MHz.fir@289136.4]
  input  [38:0] io_req_bits_addr, // @[:sifive.freedom.unleashed.DevKitU500FPGADesign_WithDevKit50MHz.fir@289137.4]
  output        io_resp_valid, // @[:sifive.freedom.unleashed.DevKitU500FPGADesign_WithDevKit50MHz.fir@289137.4]
  output        io_resp_bits_taken, // @[:sifive.freedom.unleashed.DevKitU500FPGADesign_WithDevKit50MHz.fir@289137.4]
  output        io_resp_bits_bridx, // @[:sifive.freedom.unleashed.DevKitU500FPGADesign_WithDevKit50MHz.fir@289137.4]
  output [38:0] io_resp_bits_target, // @[:sifive.freedom.unleashed.DevKitU500FPGADesign_WithDevKit50MHz.fir@289137.4]
  output [4:0]  io_resp_bits_entry, // @[:sifive.freedom.unleashed.DevKitU500FPGADesign_WithDevKit50MHz.fir@289137.4]
  output [7:0]  io_resp_bits_bht_history, // @[:sifive.freedom.unleashed.DevKitU500FPGADesign_WithDevKit50MHz.fir@289137.4]
  output        io_resp_bits_bht_value, // @[:sifive.freedom.unleashed.DevKitU500FPGADesign_WithDevKit50MHz.fir@289137.4]
  input         io_btb_update_valid, // @[:sifive.freedom.unleashed.DevKitU500FPGADesign_WithDevKit50MHz.fir@289137.4]
  input  [4:0]  io_btb_update_bits_prediction_entry, // @[:sifive.freedom.unleashed.DevKitU500FPGADesign_WithDevKit50MHz.fir@289137.4]
  input  [38:0] io_btb_update_bits_pc, // @[:sifive.freedom.unleashed.DevKitU500FPGADesign_WithDevKit50MHz.fir@289137.4]
  input         io_btb_update_bits_isValid, // @[:sifive.freedom.unleashed.DevKitU500FPGADesign_WithDevKit50MHz.fir@289137.4]
  input  [38:0] io_btb_update_bits_br_pc, // @[:sifive.freedom.unleashed.DevKitU500FPGADesign_WithDevKit50MHz.fir@289137.4]
  input  [1:0]  io_btb_update_bits_cfiType, // @[:sifive.freedom.unleashed.DevKitU500FPGADesign_WithDevKit50MHz.fir@289137.4]
  input         io_bht_update_valid, // @[:sifive.freedom.unleashed.DevKitU500FPGADesign_WithDevKit50MHz.fir@289137.4]
  input  [7:0]  io_bht_update_bits_prediction_history, // @[:sifive.freedom.unleashed.DevKitU500FPGADesign_WithDevKit50MHz.fir@289137.4]
  input  [38:0] io_bht_update_bits_pc, // @[:sifive.freedom.unleashed.DevKitU500FPGADesign_WithDevKit50MHz.fir@289137.4]
  input         io_bht_update_bits_branch, // @[:sifive.freedom.unleashed.DevKitU500FPGADesign_WithDevKit50MHz.fir@289137.4]
  input         io_bht_update_bits_taken, // @[:sifive.freedom.unleashed.DevKitU500FPGADesign_WithDevKit50MHz.fir@289137.4]
  input         io_bht_update_bits_mispredict, // @[:sifive.freedom.unleashed.DevKitU500FPGADesign_WithDevKit50MHz.fir@289137.4]
  input         io_bht_advance_valid, // @[:sifive.freedom.unleashed.DevKitU500FPGADesign_WithDevKit50MHz.fir@289137.4]
  input         io_bht_advance_bits_bht_value, // @[:sifive.freedom.unleashed.DevKitU500FPGADesign_WithDevKit50MHz.fir@289137.4]
  input         io_ras_update_valid, // @[:sifive.freedom.unleashed.DevKitU500FPGADesign_WithDevKit50MHz.fir@289137.4]
  input  [1:0]  io_ras_update_bits_cfiType, // @[:sifive.freedom.unleashed.DevKitU500FPGADesign_WithDevKit50MHz.fir@289137.4]
  input  [38:0] io_ras_update_bits_returnAddr, // @[:sifive.freedom.unleashed.DevKitU500FPGADesign_WithDevKit50MHz.fir@289137.4]
  output        io_ras_head_valid, // @[:sifive.freedom.unleashed.DevKitU500FPGADesign_WithDevKit50MHz.fir@289137.4]
  output [38:0] io_ras_head_bits, // @[:sifive.freedom.unleashed.DevKitU500FPGADesign_WithDevKit50MHz.fir@289137.4]
  input         io_flush // @[:sifive.freedom.unleashed.DevKitU500FPGADesign_WithDevKit50MHz.fir@289137.4]
);
  reg  _T_1161 [0:511]; // @[BTB.scala 113:26:sifive.freedom.unleashed.DevKitU500FPGADesign_WithDevKit50MHz.fir@290145.4]
  reg [31:0] _RAND_0;
  wire  _T_1161__T_1232_data; // @[BTB.scala 113:26:sifive.freedom.unleashed.DevKitU500FPGADesign_WithDevKit50MHz.fir@290145.4]
  wire [8:0] _T_1161__T_1232_addr; // @[BTB.scala 113:26:sifive.freedom.unleashed.DevKitU500FPGADesign_WithDevKit50MHz.fir@290145.4]
  wire  _T_1161__T_1245_data; // @[BTB.scala 113:26:sifive.freedom.unleashed.DevKitU500FPGADesign_WithDevKit50MHz.fir@290145.4]
  wire [8:0] _T_1161__T_1245_addr; // @[BTB.scala 113:26:sifive.freedom.unleashed.DevKitU500FPGADesign_WithDevKit50MHz.fir@290145.4]
  wire  _T_1161__T_1245_mask; // @[BTB.scala 113:26:sifive.freedom.unleashed.DevKitU500FPGADesign_WithDevKit50MHz.fir@290145.4]
  wire  _T_1161__T_1245_en; // @[BTB.scala 113:26:sifive.freedom.unleashed.DevKitU500FPGADesign_WithDevKit50MHz.fir@290145.4]
  reg [12:0] idxs_0; // @[BTB.scala 188:17:sifive.freedom.unleashed.DevKitU500FPGADesign_WithDevKit50MHz.fir@289142.4]
  reg [31:0] _RAND_1;
  reg [12:0] idxs_1; // @[BTB.scala 188:17:sifive.freedom.unleashed.DevKitU500FPGADesign_WithDevKit50MHz.fir@289142.4]
  reg [31:0] _RAND_2;
  reg [12:0] idxs_2; // @[BTB.scala 188:17:sifive.freedom.unleashed.DevKitU500FPGADesign_WithDevKit50MHz.fir@289142.4]
  reg [31:0] _RAND_3;
  reg [12:0] idxs_3; // @[BTB.scala 188:17:sifive.freedom.unleashed.DevKitU500FPGADesign_WithDevKit50MHz.fir@289142.4]
  reg [31:0] _RAND_4;
  reg [12:0] idxs_4; // @[BTB.scala 188:17:sifive.freedom.unleashed.DevKitU500FPGADesign_WithDevKit50MHz.fir@289142.4]
  reg [31:0] _RAND_5;
  reg [12:0] idxs_5; // @[BTB.scala 188:17:sifive.freedom.unleashed.DevKitU500FPGADesign_WithDevKit50MHz.fir@289142.4]
  reg [31:0] _RAND_6;
  reg [12:0] idxs_6; // @[BTB.scala 188:17:sifive.freedom.unleashed.DevKitU500FPGADesign_WithDevKit50MHz.fir@289142.4]
  reg [31:0] _RAND_7;
  reg [12:0] idxs_7; // @[BTB.scala 188:17:sifive.freedom.unleashed.DevKitU500FPGADesign_WithDevKit50MHz.fir@289142.4]
  reg [31:0] _RAND_8;
  reg [12:0] idxs_8; // @[BTB.scala 188:17:sifive.freedom.unleashed.DevKitU500FPGADesign_WithDevKit50MHz.fir@289142.4]
  reg [31:0] _RAND_9;
  reg [12:0] idxs_9; // @[BTB.scala 188:17:sifive.freedom.unleashed.DevKitU500FPGADesign_WithDevKit50MHz.fir@289142.4]
  reg [31:0] _RAND_10;
  reg [12:0] idxs_10; // @[BTB.scala 188:17:sifive.freedom.unleashed.DevKitU500FPGADesign_WithDevKit50MHz.fir@289142.4]
  reg [31:0] _RAND_11;
  reg [12:0] idxs_11; // @[BTB.scala 188:17:sifive.freedom.unleashed.DevKitU500FPGADesign_WithDevKit50MHz.fir@289142.4]
  reg [31:0] _RAND_12;
  reg [12:0] idxs_12; // @[BTB.scala 188:17:sifive.freedom.unleashed.DevKitU500FPGADesign_WithDevKit50MHz.fir@289142.4]
  reg [31:0] _RAND_13;
  reg [12:0] idxs_13; // @[BTB.scala 188:17:sifive.freedom.unleashed.DevKitU500FPGADesign_WithDevKit50MHz.fir@289142.4]
  reg [31:0] _RAND_14;
  reg [12:0] idxs_14; // @[BTB.scala 188:17:sifive.freedom.unleashed.DevKitU500FPGADesign_WithDevKit50MHz.fir@289142.4]
  reg [31:0] _RAND_15;
  reg [12:0] idxs_15; // @[BTB.scala 188:17:sifive.freedom.unleashed.DevKitU500FPGADesign_WithDevKit50MHz.fir@289142.4]
  reg [31:0] _RAND_16;
  reg [12:0] idxs_16; // @[BTB.scala 188:17:sifive.freedom.unleashed.DevKitU500FPGADesign_WithDevKit50MHz.fir@289142.4]
  reg [31:0] _RAND_17;
  reg [12:0] idxs_17; // @[BTB.scala 188:17:sifive.freedom.unleashed.DevKitU500FPGADesign_WithDevKit50MHz.fir@289142.4]
  reg [31:0] _RAND_18;
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
  reg [31:0] _RAND_166;
  reg  brIdx_18; // @[BTB.scala 197:18:sifive.freedom.unleashed.DevKitU500FPGADesign_WithDevKit50MHz.fir@289150.4]
  reg [31:0] _RAND_167;
  reg  brIdx_19; // @[BTB.scala 197:18:sifive.freedom.unleashed.DevKitU500FPGADesign_WithDevKit50MHz.fir@289150.4]
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
