SUAT-lhy/MEISHA-V100-A-Silicon-Proven-Quad-Core-RISC-V-SoC/(commit log)

2026-03-20 修改图片显示不完全以及不居中的问题
2026-03-25 upload MEISHA-V100 source code
    [NVDLA_OpenSource_Performance.xlsx, cdp_1x1x1_lrn3_int8_0.cfg, cdp_1x1x31_lrn3_int8_0.cfg, cdp_33x17x34_lrn5_int8_0.cfg, cdp_8x8x32_lrn3_int8_0.cfg, cdp_8x8x32_lrn3_int8_1.cfg, cdp_8x8x32_lrn3_int8_2.cfg, cdp_8x8x32_lrn5_int8_0.cfg]
